AdamC19/RMC-Computer-2021/README.md

# Computer Board for NASA RMC 2021
These are the hardware files for our main computer board for our 2021 entry for NASA RMC: Lunabotics.
