AdamC19/RMC-Computer-2021/Project Outputs for Computer_Board/Computer_Board_BoM.xlsx

Manufacturer PN | Description | Designator | Quantity | Cost
BU2032SM-JJ-GTR | Battery Holder, Coin Cell CR2032, SMD | BT1 | 1 | 1
 | CAP, 0.1uF, ±10%, 16V, X7R, 0603 | C1, C12, C16, C19, C30, C31, C32, C35, C36, C38, C39, C44, C45, C46, C47, C48, C49, C50, C51, C52, C53, C56, C57, C58, C59, C60, C61, C62, C63, C64, C65, C66, C67, C68, C69, C70, C71, C72, C73, C74, C75, C76, C78, C83, C85, C86, C87, C88, C90, C91, C92, C93, C94, C95, C96, C97, C98, C102, C103, C104, C105, C109, C110, C112, C113, C122, C123, C124, C125, C130 | 70
CL31B106KAHNNNE | CAP, 10uF, ±10%, 25V, X7R, 1206 | C2, C3, C5, C7, C8, C13, C14, C15, C20, C21, C22, C25, C26, C33, C34, C40, C41, C42, C43, C77, C84 | 21
GRM21BR71C105KA01K | CAP, 1uF, 10%, 16V, X7R, 0805 | C4, C18, C23, C37, C80, C117, C118, C119, C120, C121 | 10
C1210C476M9RACTU | CAP, 47uF, ±20%, 6.3V, X7R, 1210 | C6, C17, C24 | 3 | $1.08
 | CAP, 10000pF, ±10%, 16V, X7R, 0603 | C9, C27, C89 | 3
GRM1885C1H390FA01D | CAP, 39pF, ±1%, 50V, C0G, 0603 | C10, C28 | 2
GRM1885C1H102FA01D | CAP, 1000pF, ±1%, 50V, C0G, 0603 | C11, C29, C99, C100, C101, C106, C107, C108, C111, C114, C115, C116 | 12
GRM1885C1H470GA01J | CAP, 47pF, ±2%, 50V, C0G, 0603 | C54, C55 | 2
GRM1885C1H471GA01D | CAP, 470pF, ±2%, 50V, C0G, 0603 | C79 | 1
GRM1885C1H180GA01D | CAP, 18pF, ±2%, 50V, C0G, 0603 | C81, C82 | 2
T495X227K016ATE100 | CAP, 220uF, ±10%, 16V, Tantalum, 100mOhm, 2917 | C126, C127, C128 | 3 | $2.57
UCW1E471MNL1GS | CAP, 470uF, ±20%, 25V, Al, SMD, 7000hrs at 105°C | C129 | 1 | $0.70
SS5P6-M3/86A | Dio, Schottky, 5A, 0.63V, 60V, TO-227 | D1, D2, D3, D4 | 4 | 0.6
DLPT05-7-F | TVS, Steering (Rail-Rail), 9.8V Clamping, 17A Peak Pulse, SOT-23 | D5, D6, D9, D10, D11, D12, D13, D14, D21, D22, D23, D24, D25, D26, D27, D28, D29, D30, D31, D32, D33, D34, D35, D36, D37, D38 | 26 | 0.38
MBR140SFT1G | Dio Shtky, 1A, 0.55V, 40V, SOD-123 | D7, D15, D16, D17, D20, D39 | 6
APT1608LVBC/D | LED, Blue, 0603, Low current, HELI2 Series | D8, D18, D19 | 3 | 0.58
PTS12066V050 | PTC Resettable fuse, 6V, 500mA, 1206 | F1, F3, F4, F5, F6, F8, F9, F10, F11 | 9 | 0.3
1210L150/16WR | PTC Fuse (Polyfuse), 16V 1.5A Hold, 3A Trip, 300ms | F2, F7 | 2 | 1
TSW-102-07-F-S | Header, 2x1, 0.1" | J1, J18, J20, P2 | 4 | 0.2
1-1393644-6 | DIN 41612 Plug, 96-Pos, Male Pins, Right-Angle | J2 | 1 | 7.49
3-1827253-6 | Plug, 220 pos, COM Express Board-Board connector | J3 | 1 | 18.99
0470531000 | Header, 4-Pos, Molex-47053, (CPU Fan Header) | J4 | 1 | 0.46
J0G-0003NL | RJ45 Modular Mag-jack, 8P8C, 1000 Base-T, Horizontal | J5 | 1 | 10.26
1003-004-01010 | USB-A Jack x2, USB 3.0, Right-Angle, Thru-Hole | J6 | 1 | 3.55
UJ2-ADH-1-TH | USB-A Jack x2, USB 2.0, Right-Angle, Thru-Hole | J7, J8 | 2 | 0.95
10029449-111RLF | HDMI Type A Jack, Right-Angle, SMD+Thru-Hole | J9 | 1 | 0.8
2199230-4 | Card-Edge Socket, NGFF (M.2) E-Keyed, PCIe Card Socket | J10 | 1 | 1.33
1040310811 | Micro SD Card Slot, Push-Pull w/ Card-Detect Switch, SMD, Molex | J11 | 1 | 2.02
RJMG1BD3B8K1ANR | RJ45 Modular Mag-Jack, 8P8C, 10/100 Base-T | J12 | 1 | 3.92
1932638-3 | USB-A Jack, USB 2.0, SMD Right-Angle | J13 | 1 | 1.52
 | Net Tie | J14, J15, J16, J17 | 4
 | Header 6x1, 0.1" | J19, P3, P4 | 3
DFE252012P-R47M=P2 | Ind, 470nH, 4A, 0.027 Ohm, 1008 | L1, L5 | 2 | 0.51
IHLP3232DZER100M01 | Ind, 10uH, 20%, 5.2A (9A sat.), 0.0599 Ohm | L2, L6 | 2 | 1.65
MLZ2012A1R0WTD25 | Ind, 1uH, 20%, 900mA, 0805 | L3 | 1
SRN5040-3R3M | Ind, 3.3uH, 3.3A (3.8A sat.), 0.027 Ohm | L4 | 1 | 0.46
PE-0805PFB600ST | Fe Bead, 60 @ 100MH, 3A, 0805 | L7, L8, L9, L10, L11, L12, L13, L20, L21 | 9 | 0.1
BLM18AG121SN1D | Fe Bead, 120 @ 100MHz, 800mA, 0603 | L14, L15, L16, L17, L18, L19 | 6 | 0.1
BCM1.STR | BeagleCore BCM1, System-On-Module (SOM) | MOD1 | 1
RAPC722X | Barrel Jack, 2.0x5.5mm IDxOD, Right-Angle | P1 | 1 | 1.64
BSS138 | XSTR NMOS, 220mA, 50V, Vgs 1.3V, SOT-23-3 | Q1, Q2, Q3, Q4, Q5, Q6, Q7, Q8, Q9, Q10, Q11, Q12, Q13 | 13 | 0.31
ERJ-PA3F1002V | RES SMD 10K OHM 1% 1/4W 0603 | R1, R6, R8, R13, R14, R16, R18, R23, R24, R25, R26, R27, R28, R44, R45, R46, R53, R56, R57, R58, R59, R60, R61, R66, R67, R78, R79, R81, R82, R90, R91, R92, R93, R94, R95, R96, R101, R102, R103, R104, R106, R107, R114, R126, R127, R128, R133, R134 | 48 | 0.144
KTR10EZPF6042 | RES SMD 60.4K OHM 1% 1/8W 0805 | R2, R9 | 2
ERJ-PA3F2402V | RES SMD 24K OHM 1% 1/4W 0603 | R3, R10 | 2
ERJ-PA3F2703V | RES SMD 270K OHM 1% 1/4W 0603 | R4, R11 | 2
KTR10EZPF1152 | RES SMD 11.5K OHM 1% 1/8W 0805 | R5, R12 | 2
ERJ-PA3F3302V | RES SMD 33K OHM 1% 1/4W 0603 | R7 | 1
ERJ-PA3F1001V | RES SMD 1K OHM 1% 1/4W 0603 | R15, R129, R130 | 3
ERJ-PA3F2201V | RES SMD 2.2K OHM 1% 1/4W 0603 | R17, R38, R39, R41, R42, R108, R109, R131, R132 | 9
ERJ-PA3F3300V | RES SMD 330 OHM 1% 1/4W 0603 | R19, R20, R54, R62, R63, R68, R77 | 7
ERJ-PA3F1000V | RES SMD 100 OHM 1% 1/4W 0603 | R21, R22, R51, R52, R65, R74, R75, R76, R123, R124 | 10
ERJ-PA3F4703V | RES SMD 470K OHM 1% 1/4W 0603 | R29 | 1
RMCF0805ZT0R00 | RES SMD 0 OHM 1/8W 0805 Thick Film | R30, R31, R32, R33, R34, R35, R37, R47, R48, R49, R50, R64, R83, R125 | 14 | 0.1
ERJ-PA3F1003V | RES SMD 100K OHM 1% 1/4W 0603 | R36, R43, R55, R105 | 4
RMCF0603FT12K4 | RES SMD 12.4K OHM 1% 1/10W 0603 | R40, R80 | 2 | 0.1
RC0603FR-0749R9L | RES SMD 49.9 OHM 1% 1/10W 0603 | R69, R70, R71, R72 | 4 | 0.1
ERJ-PA3F1501V | RES SMD 1.5K OHM 1% 1/4W 0603 | R73, R111, R112, R113, R116, R117, R118, R119, R120, R121, R122 | 11
KTR10EZPF60R4 | RES SMD 60.4 OHM 1% 1/8W 0805 | R84, R87 | 2
KTR10EZPF4700 | 20 | R85, R86, R88, R89, R97, R98, R99, R100, R110, R115 | 10
EXB-38V101JV | RES ARRAY 4 RES 100 OHM 5% 62.5mW 1206 | RN1, RN2 | 2 | 0.1
B3FS-1012P | Switch, SPST-NO, Tactile, 6.3x6.0mm, SMD, 50mA 24VDC | SW1, SW2, SW3 | 3 | 0.71
DLW21HN900SQ2L | CMC, 330mA 2-CH 90 OHM @ 100MHz SMD | T1, T2, T3, T4, T5, T6, T7, T8, T9, T10, T11 | 11 | 0.53
TPS54561DPRR | REG, SW Buck Adj, 5A, 4.5-60V, 2.5MHz, TPS54561 | U1, U4 | 2 | 5.52
UWS-12/4.5-Q48N-C | Module, Isolated, 1/16 Brick, 12V 4.5A (54W) Negative Logic | U2 | 1 | 32
TPS562201DDCR | REG, Synchronous Buck, 2A, 4.5-17V Input, SOT-23-6, TPS562201 | U3 | 1 | 0.68
SN74LVC2G04 | Inverter, Dual, sot-23-6, SN74LVC2G04 | U5, U51, U52 | 3
TPD4E02B04DQAR | TVS, 4-Ch, ESD Protec, 3.6V 8.8V 10-USON | U6, U7, U15, U17, U24, U26, U27, U29, U30, U32 | 10 | 0.56
SN74LVC1G126DBVR | IC, Tri-State Buffer Non-Inverting, Single, 1.65-5.5V, SOT-23-5 | U8, U9, U12 | 3 | $0.32
SN74LVC1G11DBVR | IC, AND Gate, Single 3-Input, 1.65-5.5V, SOT-23-6 | U10, U11, U28 | 3 | $0.37
USBLC6-2SC6Y | ESD Protec, 2-Ch, 2.5pF, 17V clamping voltage, SOT23-6 | U13, U16, U20, U21, U22, U23, U34 | 7 | 0.73
TPS2066DGNR | IC, Power Switch 1:2, 8-MSOP | U14, U18, U19, U33 | 4 | 1.56
PTN3366BSMP | IC, Video Level Shifter, HDMI v1.4b, 32-HVQFN, PTN3366 | U25 | 1 | 0.94
LAN8710AI-EZK-TR | IC, 10/100 Ethernet Transceiver | U31 | 1 | 1.56
ADM3050EBRWZ | Isolated CANbus Transceiver, Single channel, ADM3050E | U35 | 1 | 9.62
TLP291-4 | Opto-Coupler Array, Photo-Transistor Output, TLP291-4 | U36, U39 | 2
SN74HC138DR | IC, 3:8 Decoder/Demux, SOIC-16, 2V-6V | U37 | 1 | $0.37
ADuM3211ARZ | Digital Isolator, Dual-Channel, ADuM3211 | U38, U49 | 2 | 2.87
ISO1541DR | IC, Bidirectional I2C Isolator, 2500 Vrms, Low Power, SOIC-8 | U40 | 1 | 4.05
ADT7310TRZ | IC, 0.5°C Accurate 16-bit Digital SPI Temperature Sensor, SOIC-8, ADT7310 | U41 | 1 | 3.93
LT1920CS8#PBF | IC, Instrumentation Amp, Single, 4.6 ~ 36V supply, SOIC-8 | U42, U45 | 2 | 7.61
SN74AHC1G125DBVR | Tri-State Buffer, Single, 2-5.5V, SOT-23-5, SN74AHC1G125 | U43 | 1 | $0.33
ADuM3153BRSZ | Digital Isolator, SPI-bus optomized, ADuM3151 | U44 | 1 | 6.69
DG408DY | Analog Mux, 8:1, 5 ~ 36V, SOIC-16 | U46, U48 | 2 | 1.77
ADS1220IPWR | IC, ADC 24-bit 4-Channel MUX-PGA, Sigma-Delta, 2k SPS, 16-TSSOP | U47 | 1 | 8.27
MAX232CSE+ | IC, RS-232 Transceiver, Dual Channel, SOIC-16 | U50 | 1 | 2.92
ECS-250-20-33-JTN-TR | XTAL, 25MHz, 20pF, 20ppm | Y1 | 1 | 0.56
