AdamC19/RMC-Computer-2021/Computer_Board.pdf

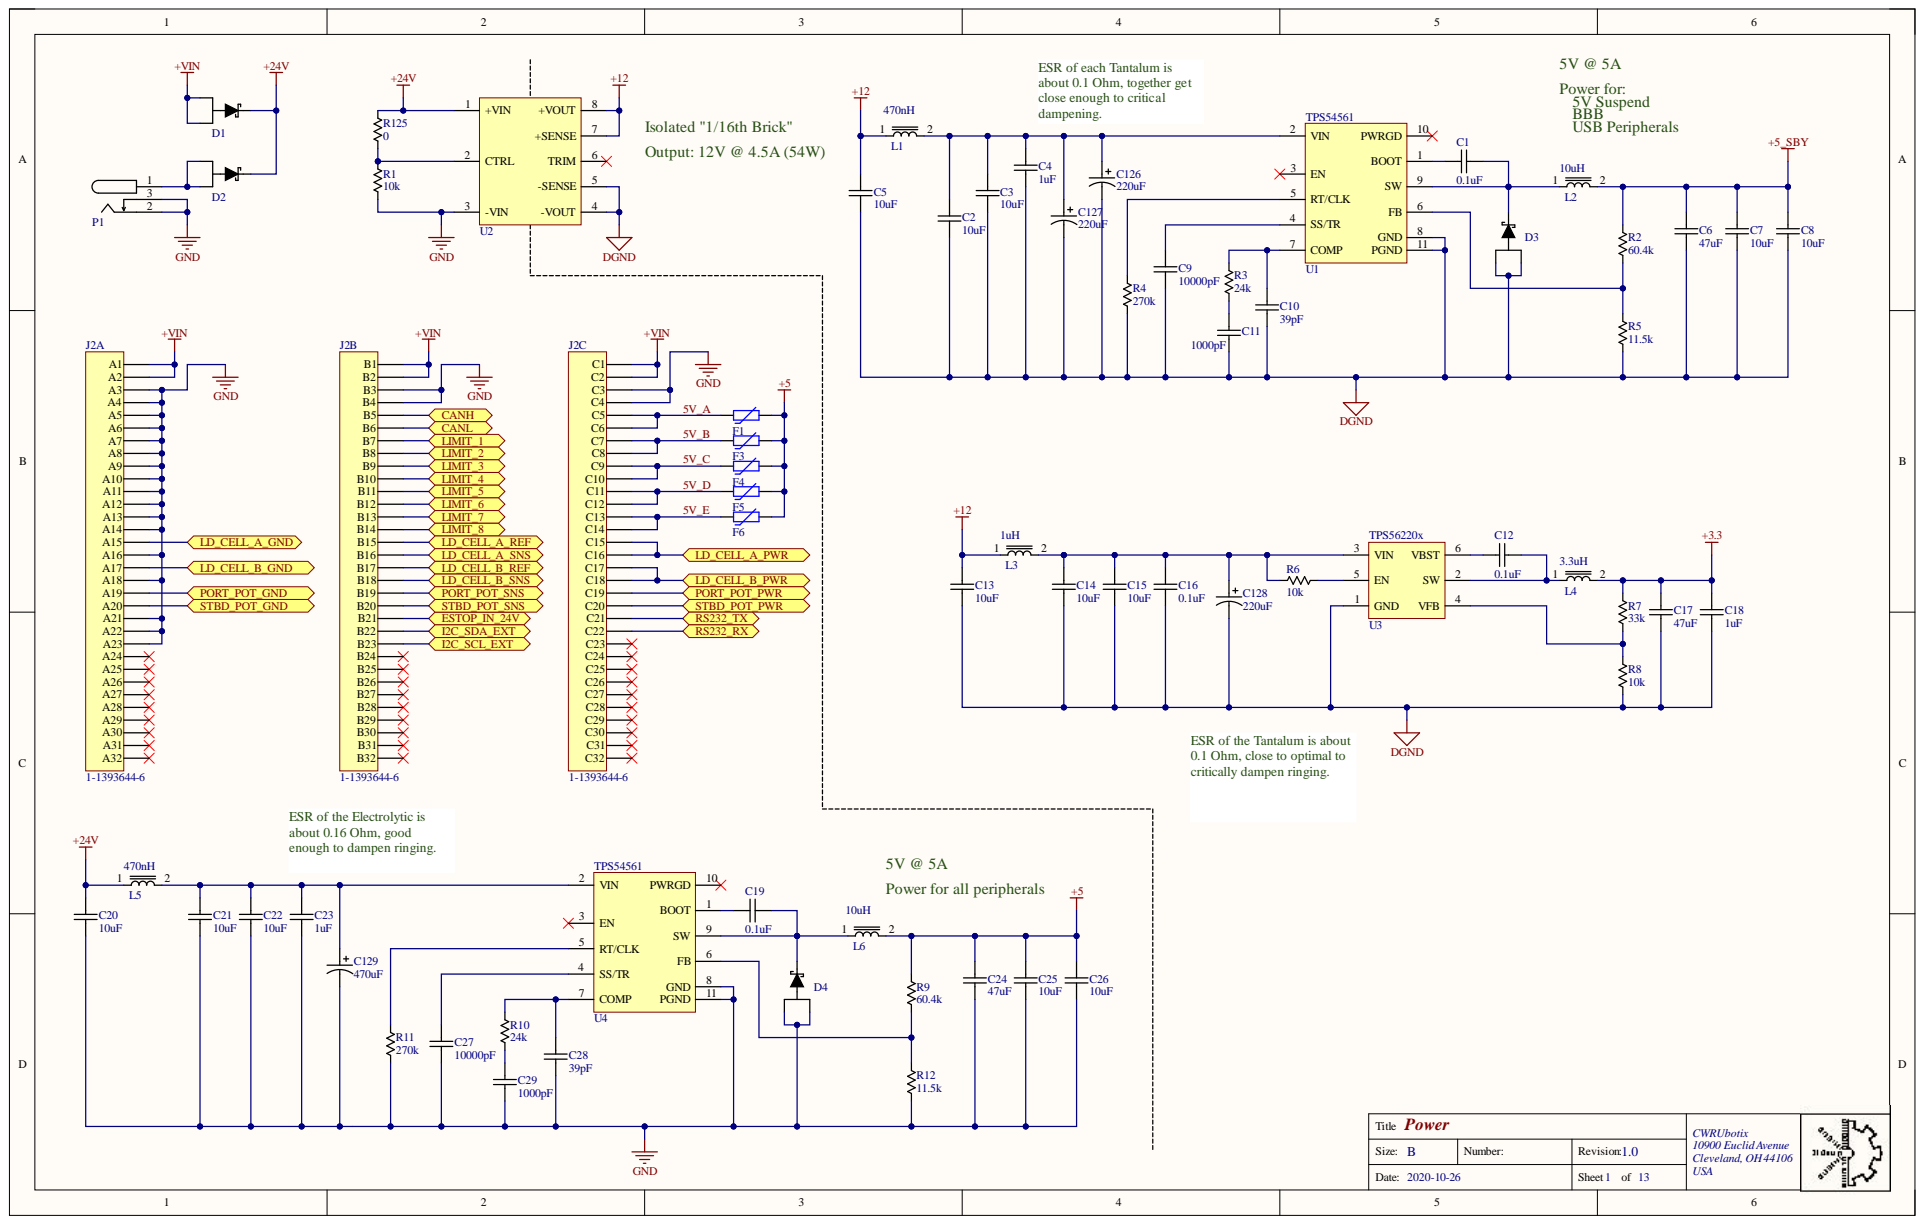
[picture p1: page 1]

ESR of each Tantalum is
about 0.1 Ohm, together get
close enough to critical
dampening.

Power for: 5V Suspend BBB

ESR of the Tantalum is about
0.1 Ohm, close to optimal to
critically dampen ringing.

ESR of the Electrolytic is
about 0.16 Ohm, good
enough to dampen ringing.

Power for all peripherals

Title Power | CWRUbotix 10900 Euclid Avenue Cleveland, OH44106

Size: B | Number: | Revision: 1.0

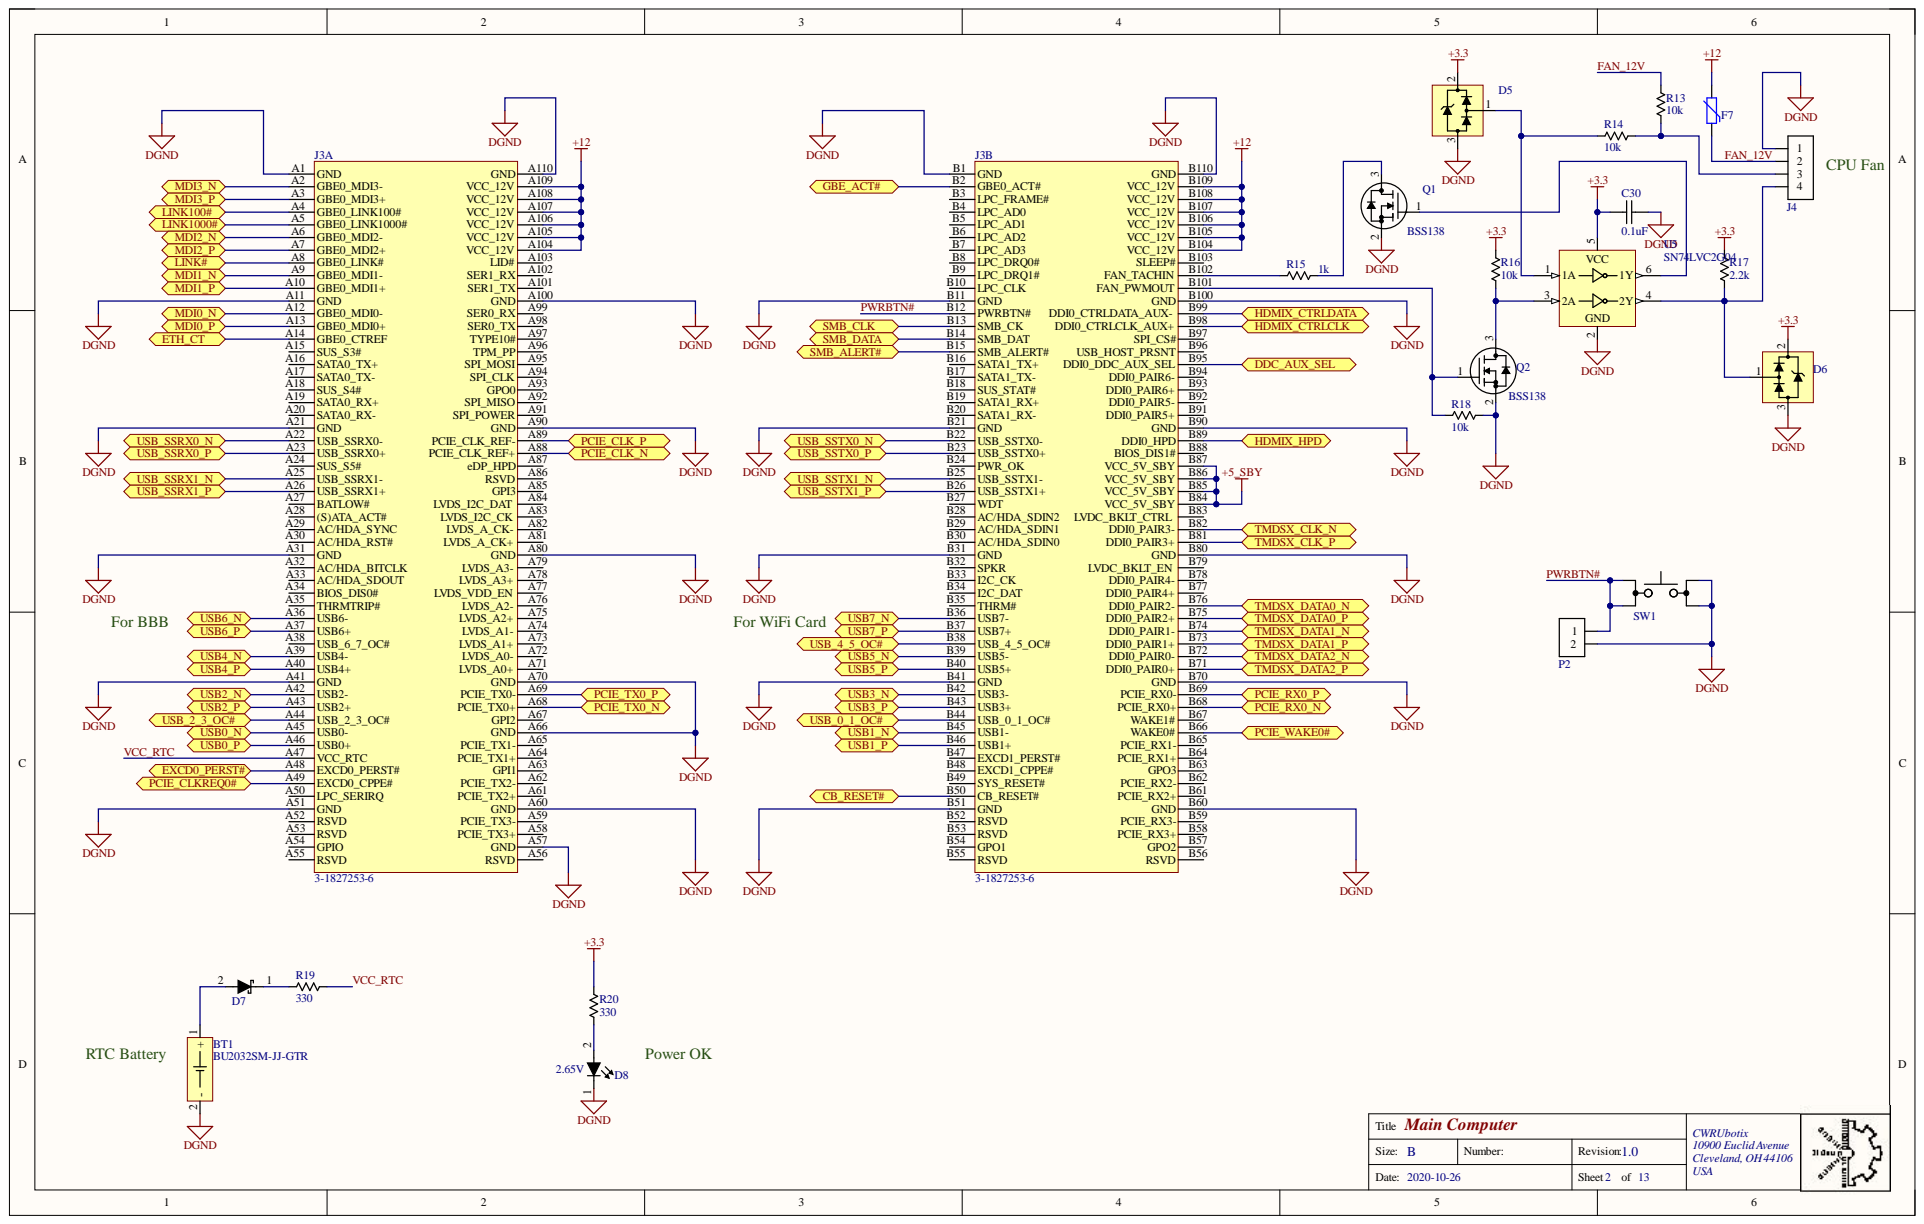
[picture p2: page 2]

Title Main Computer | CWRUbotix 10900 Euclid Avenue Cleveland, OH44106

Size: B | Number: | Revision: 1.0
Date: 2020-10-26 | | Sheet 2 of | USA 13

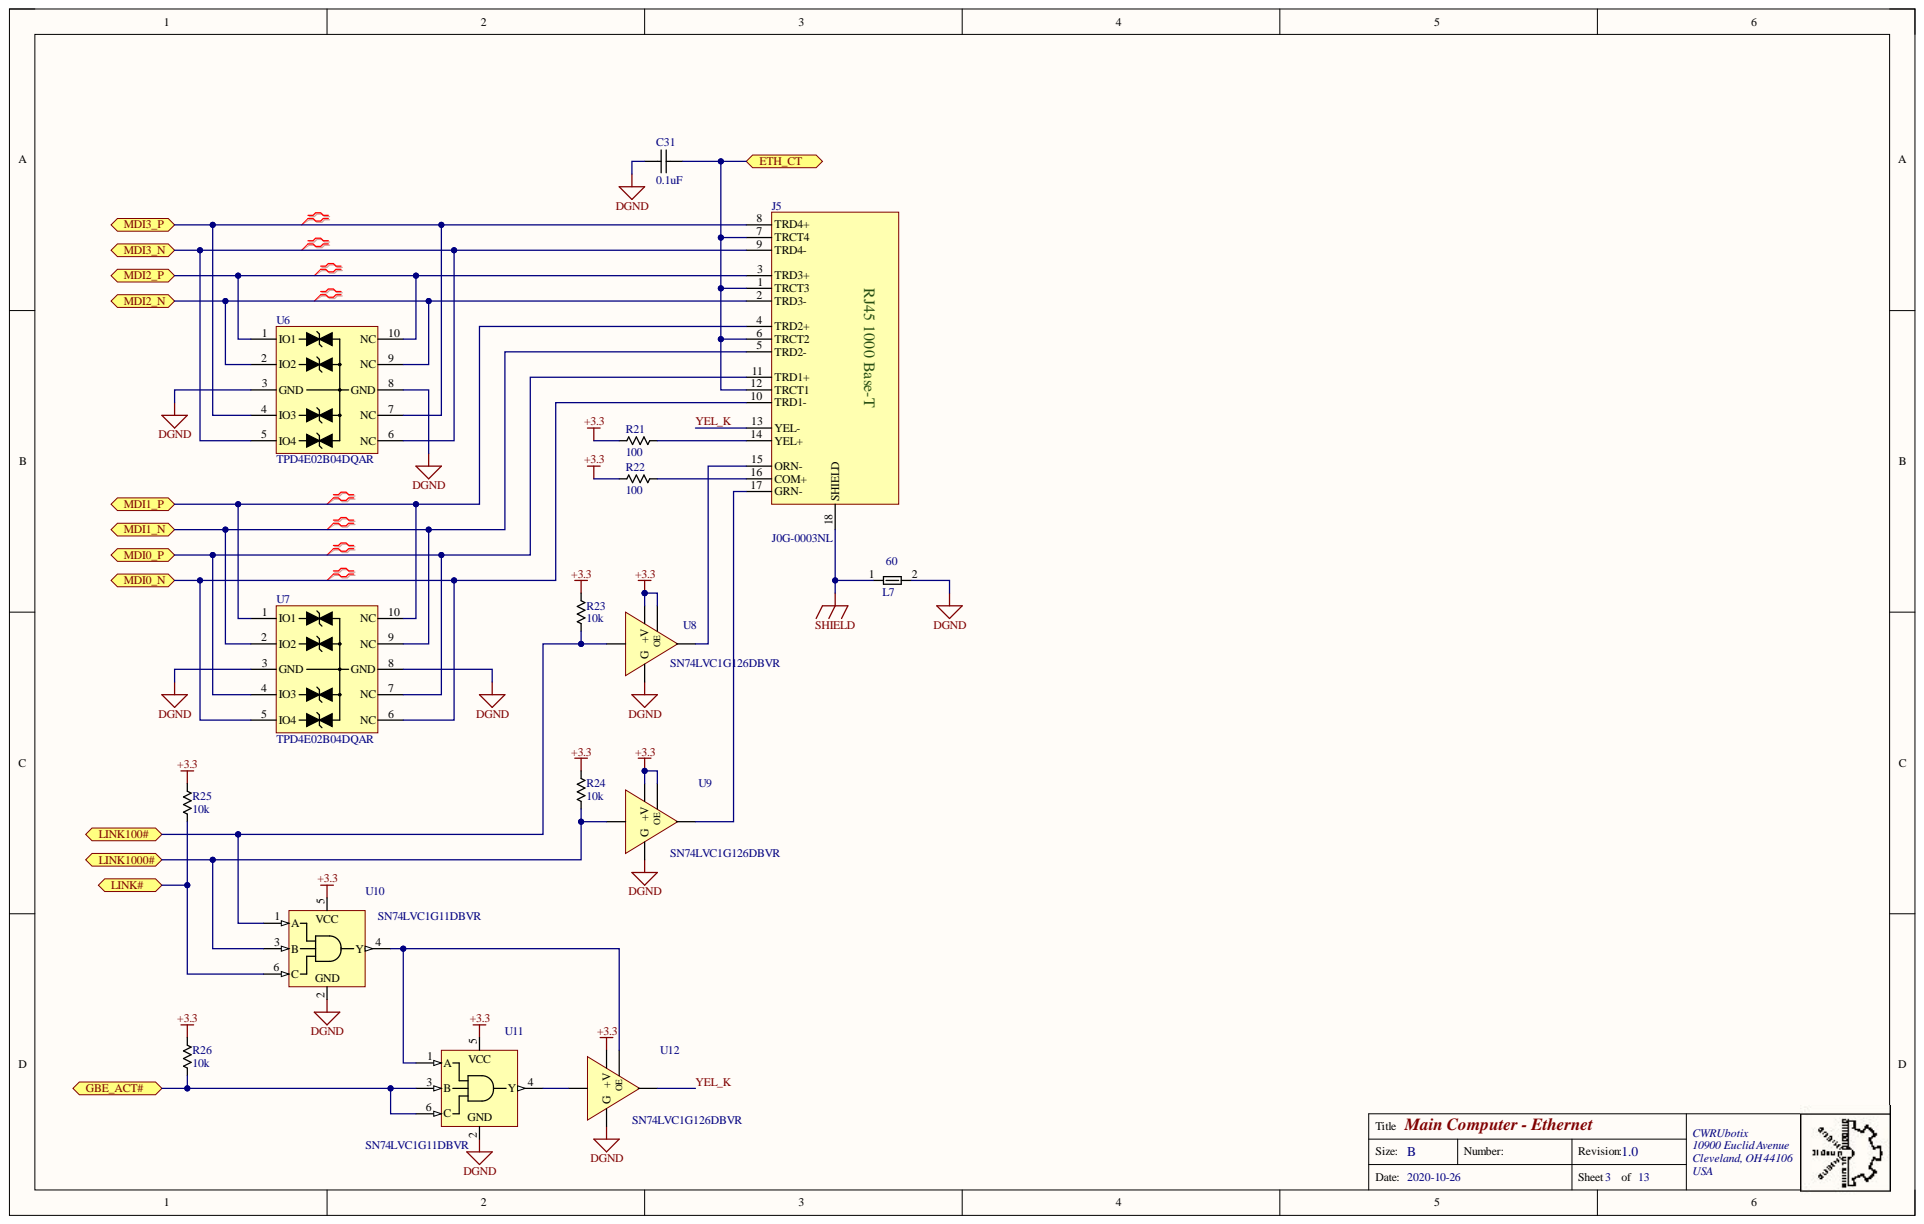
[picture p3: page 3]

TRD4- 9

TRD3+ 3
TRCT3 1
TRD3- 2

U6 | | TRD2+ 4

TRD2- 5 TRCT2 6

TRD1+ 11
TRCT1 12

Title Main Computer - Ethernet | CWRUbotix 10900 Euclid Avenue Cleveland, OH44106

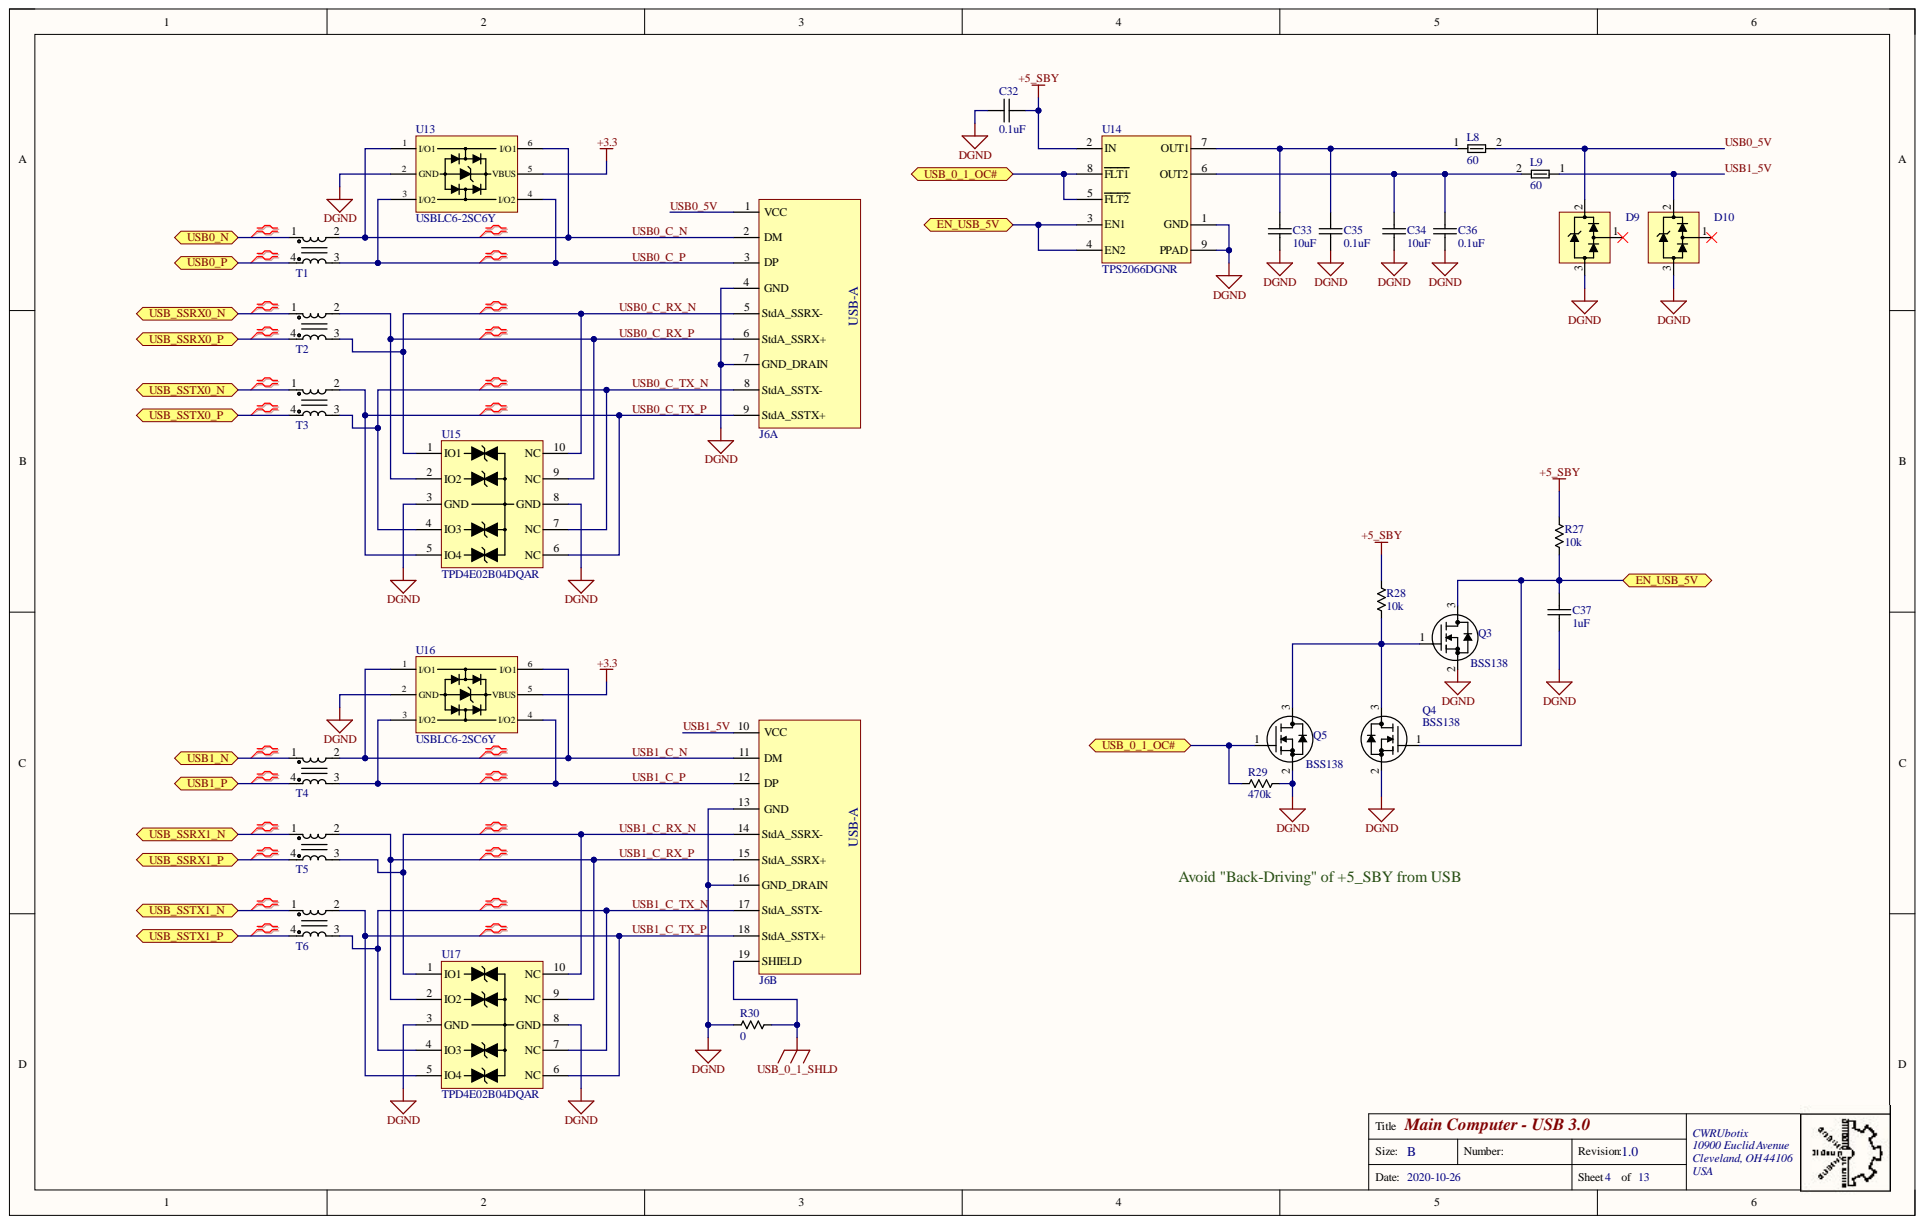
[picture p4: page 4]

StdA_SSRX- 5

USB0_C_TX_N | GND_DRAIN 7

StdA_SSTX- 8

USB0_C_TX_P

USB1_C_P | DP 12

GND 13

StdA_SSRX- 14

USB1_C_RX_P | | | StdA_SSRX+ 15

Avoid "Back-Driving" of +5_SBY from USB

USB1_C_TX_N | | | GND_DRAIN 16

StdA_SSTX- 17

USB1_C_TX_P | | StdA_SSTX+ 18

Title Main Computer - USB 3.0 | CWRUbotix 10900 Euclid Avenue Cleveland, OH44106

Size: B | Number: | Revision: 1.0
Date: 2020-10-26 | | Sheet 4 of | USA 13

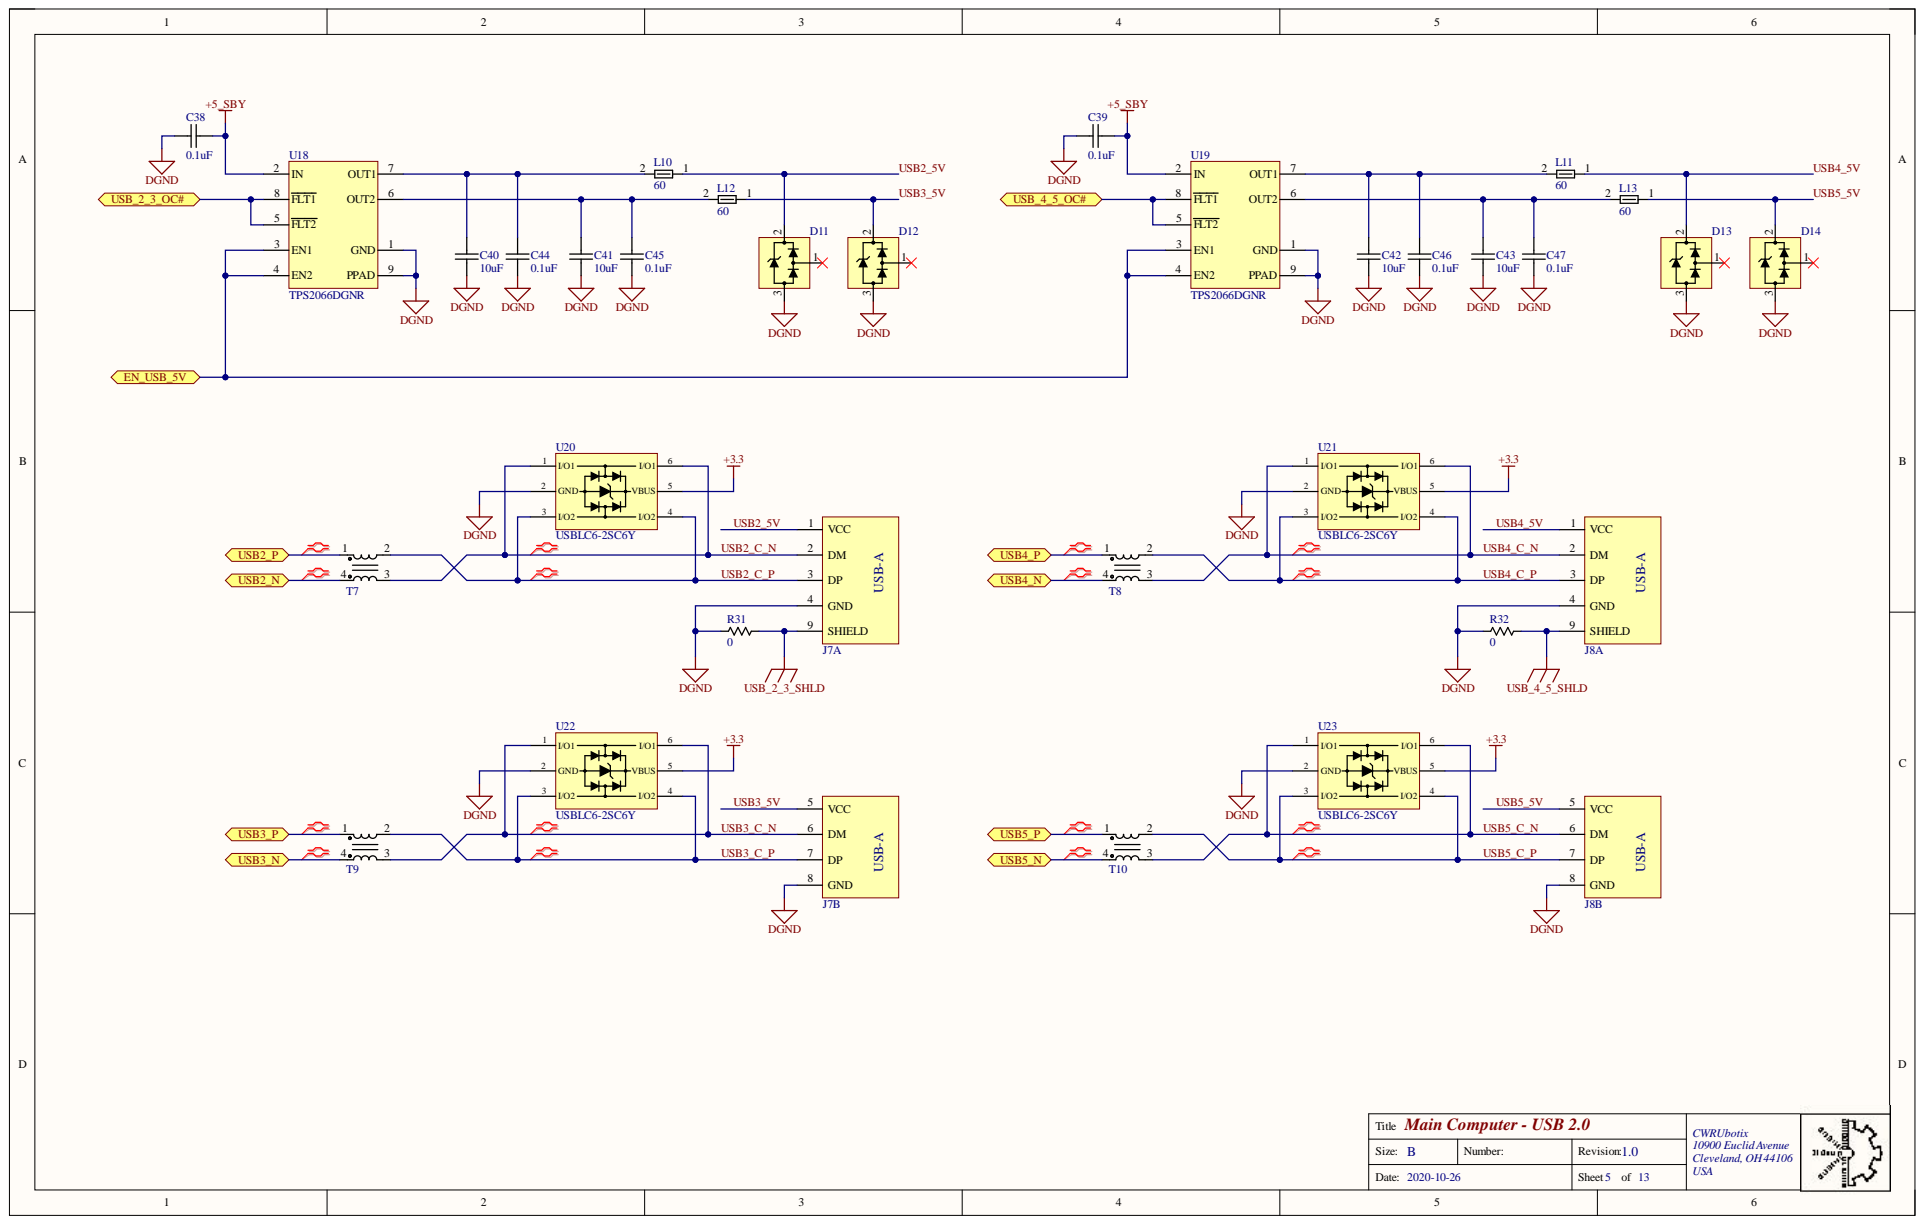
[picture p5: page 5]

Title Main Computer - USB 2.0 | CWRUbotix 10900 Euclid Avenue Cleveland, OH44106

Size: B | Number: | Revision: 1.0
Date: 2020-10-26 | | Sheet 5 of | USA 13

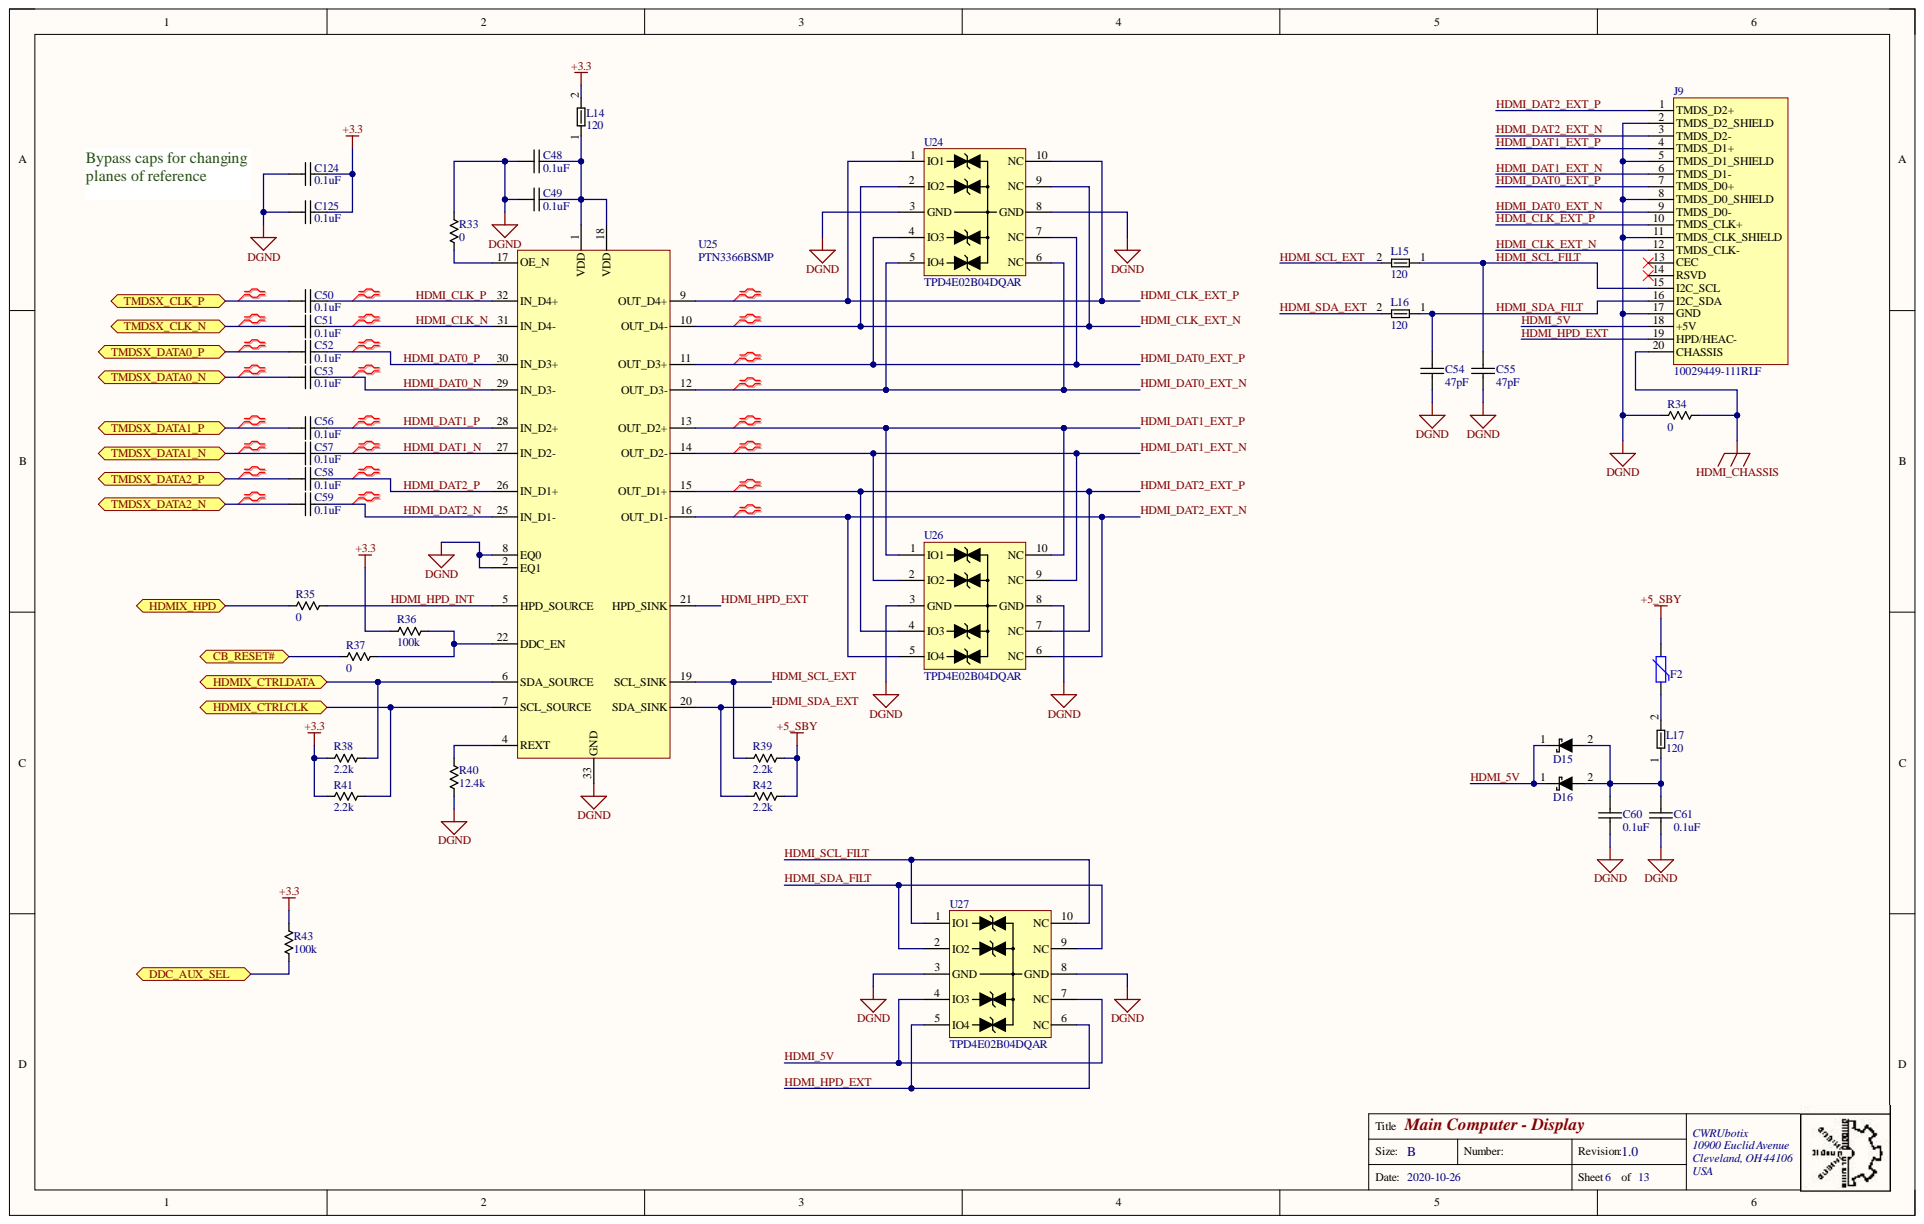
[picture p6: page 6]

Bypass caps for changing
planes of reference

0.1uF C59 | HDMI_DAT2_P

0.1uF | HDMI_DAT2_N

HDMI_SDA_FILT

HDMI_5V

HDMI_HPD_EXT

Title Main Computer - Display | CWRUbotix 10900 Euclid Avenue Cleveland, OH44106

Size: B | Number: | Revision: 1.0
Date: 2020-10-26 | | Sheet 6 of | USA 13

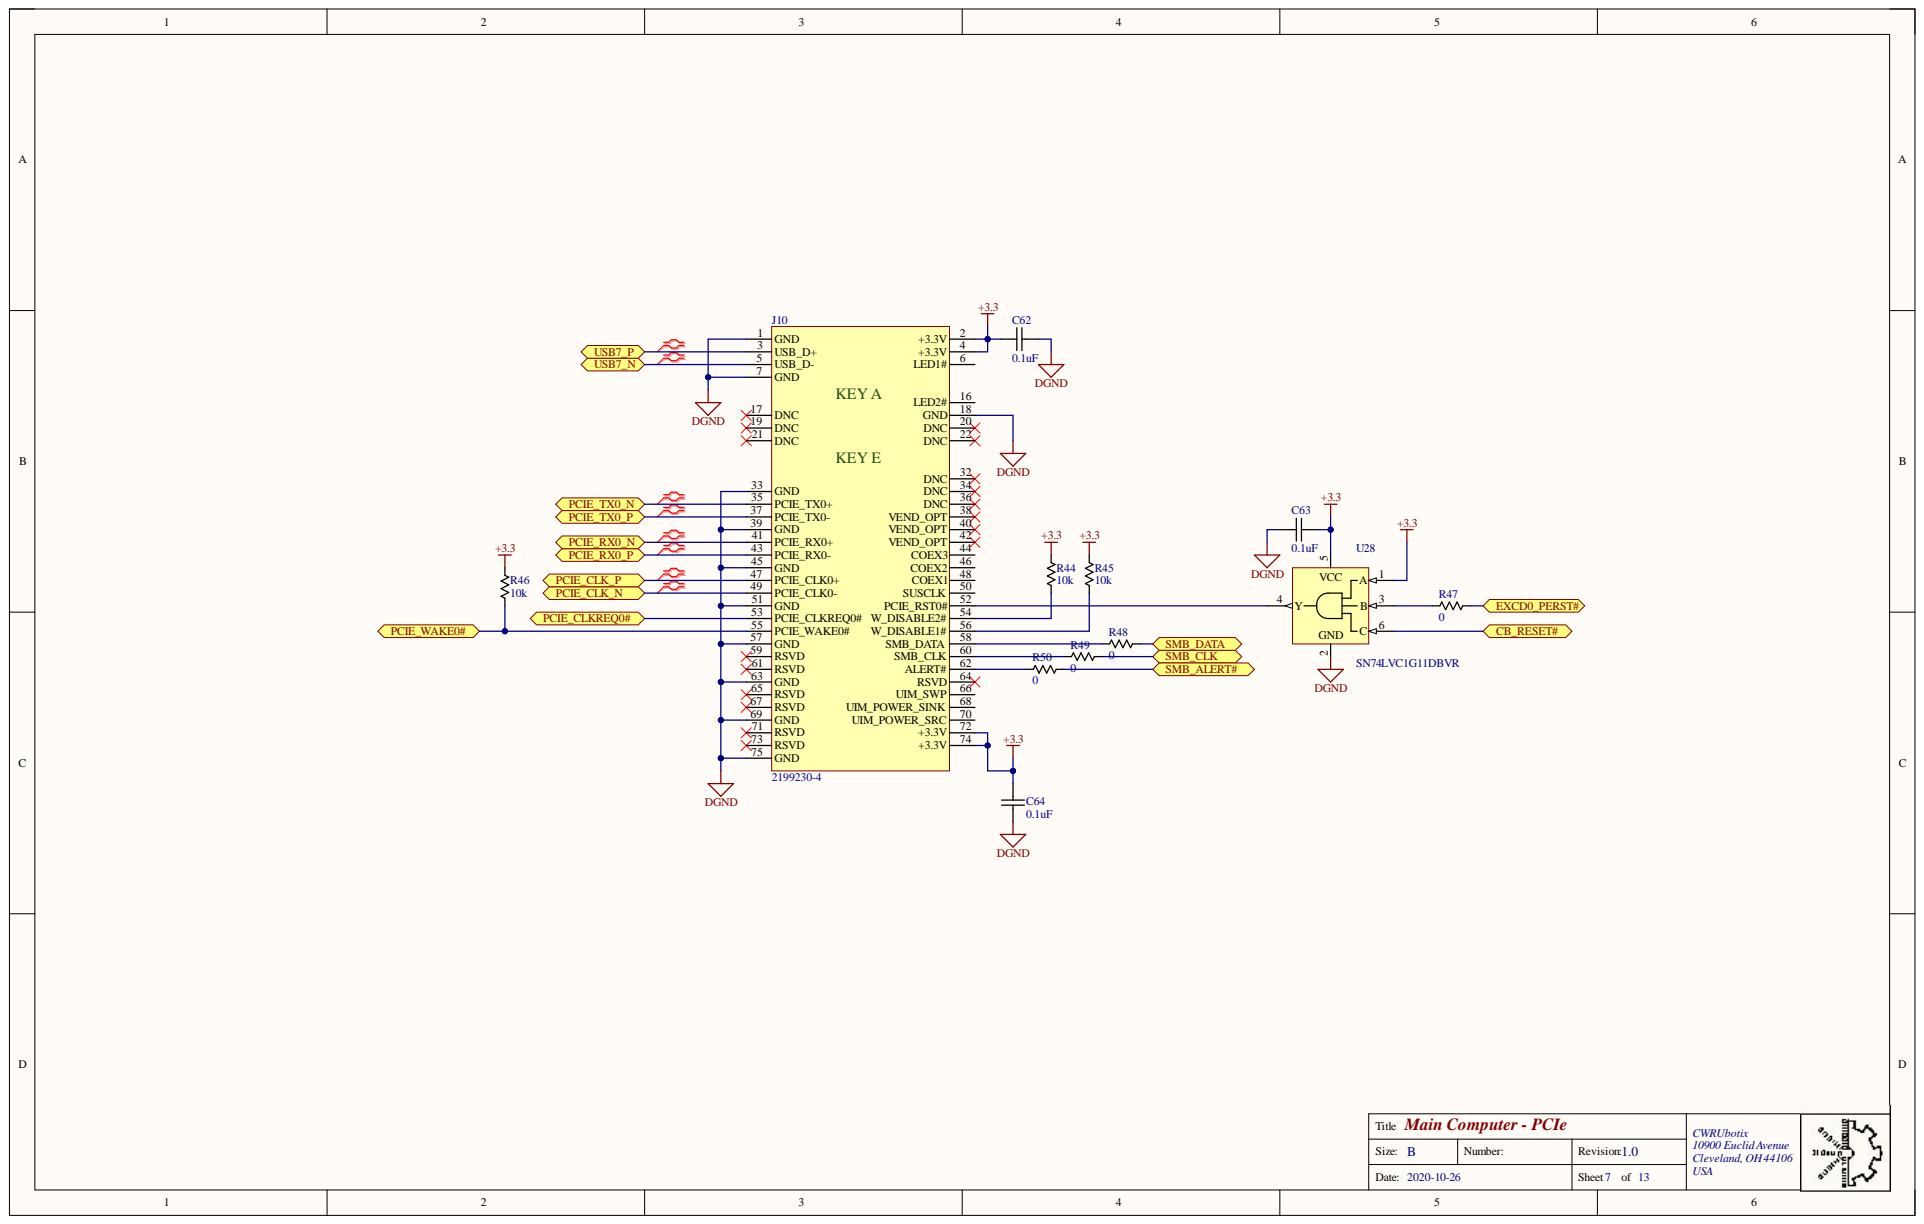
[picture p7: page 7]

Title Main Computer - PCIe | CWRUbotix 10900 Euclid Avenue Cleveland, OH44106

Size: B | Number: | Revision: 1.0
Date: 2020-10-26 | | Sheet 7 of | USA 13

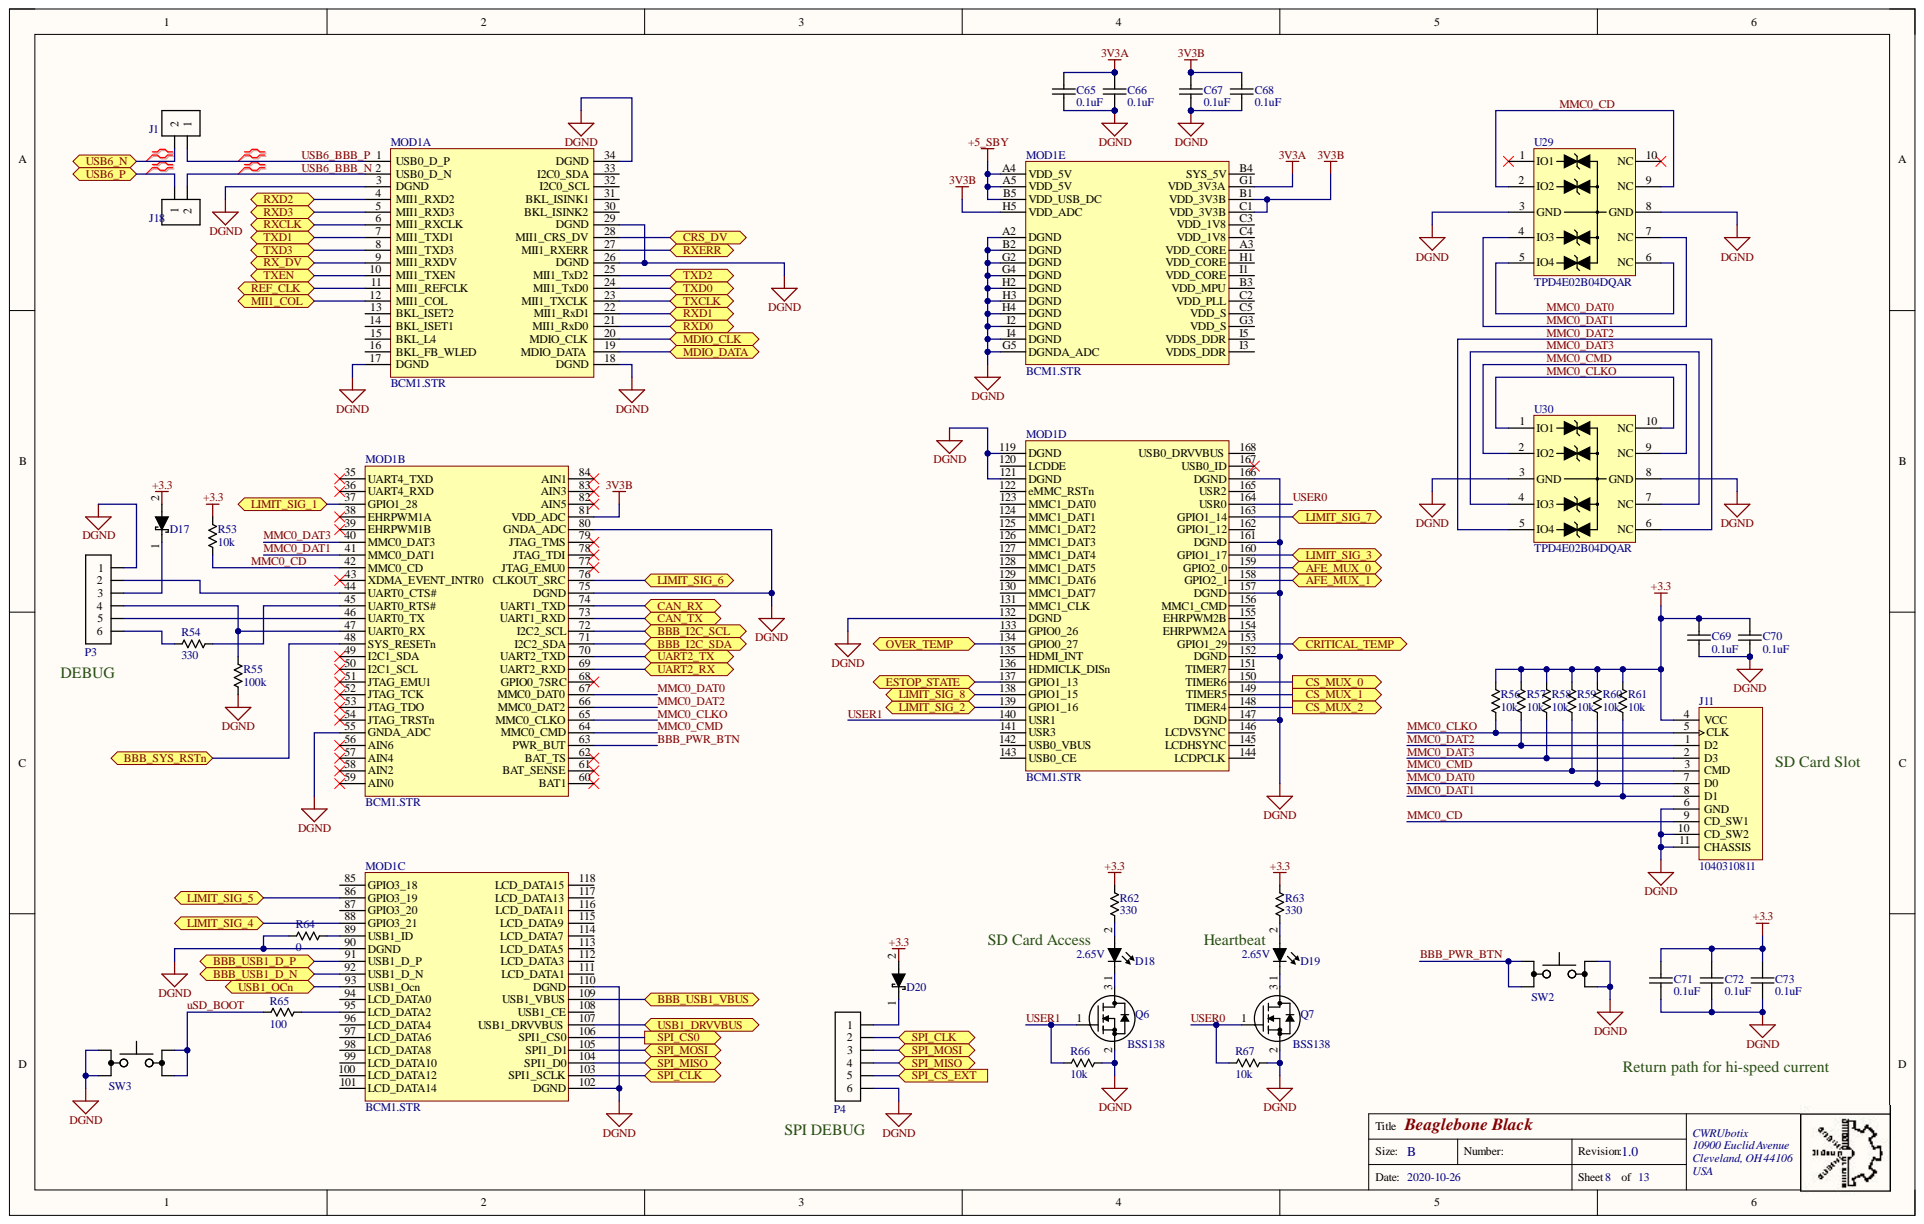
[picture p8: page 8]

CHASSIS 11

USB1_ID 89

USB1_D_P 91

Return path for hi-speed current

Title Beaglebone Black | CWRUbotix 10900 Euclid Avenue Cleveland, OH44106

Size: B | Number: | Revision: 1.0
Date: 2020-10-26 | | Sheet 8 of | USA 13

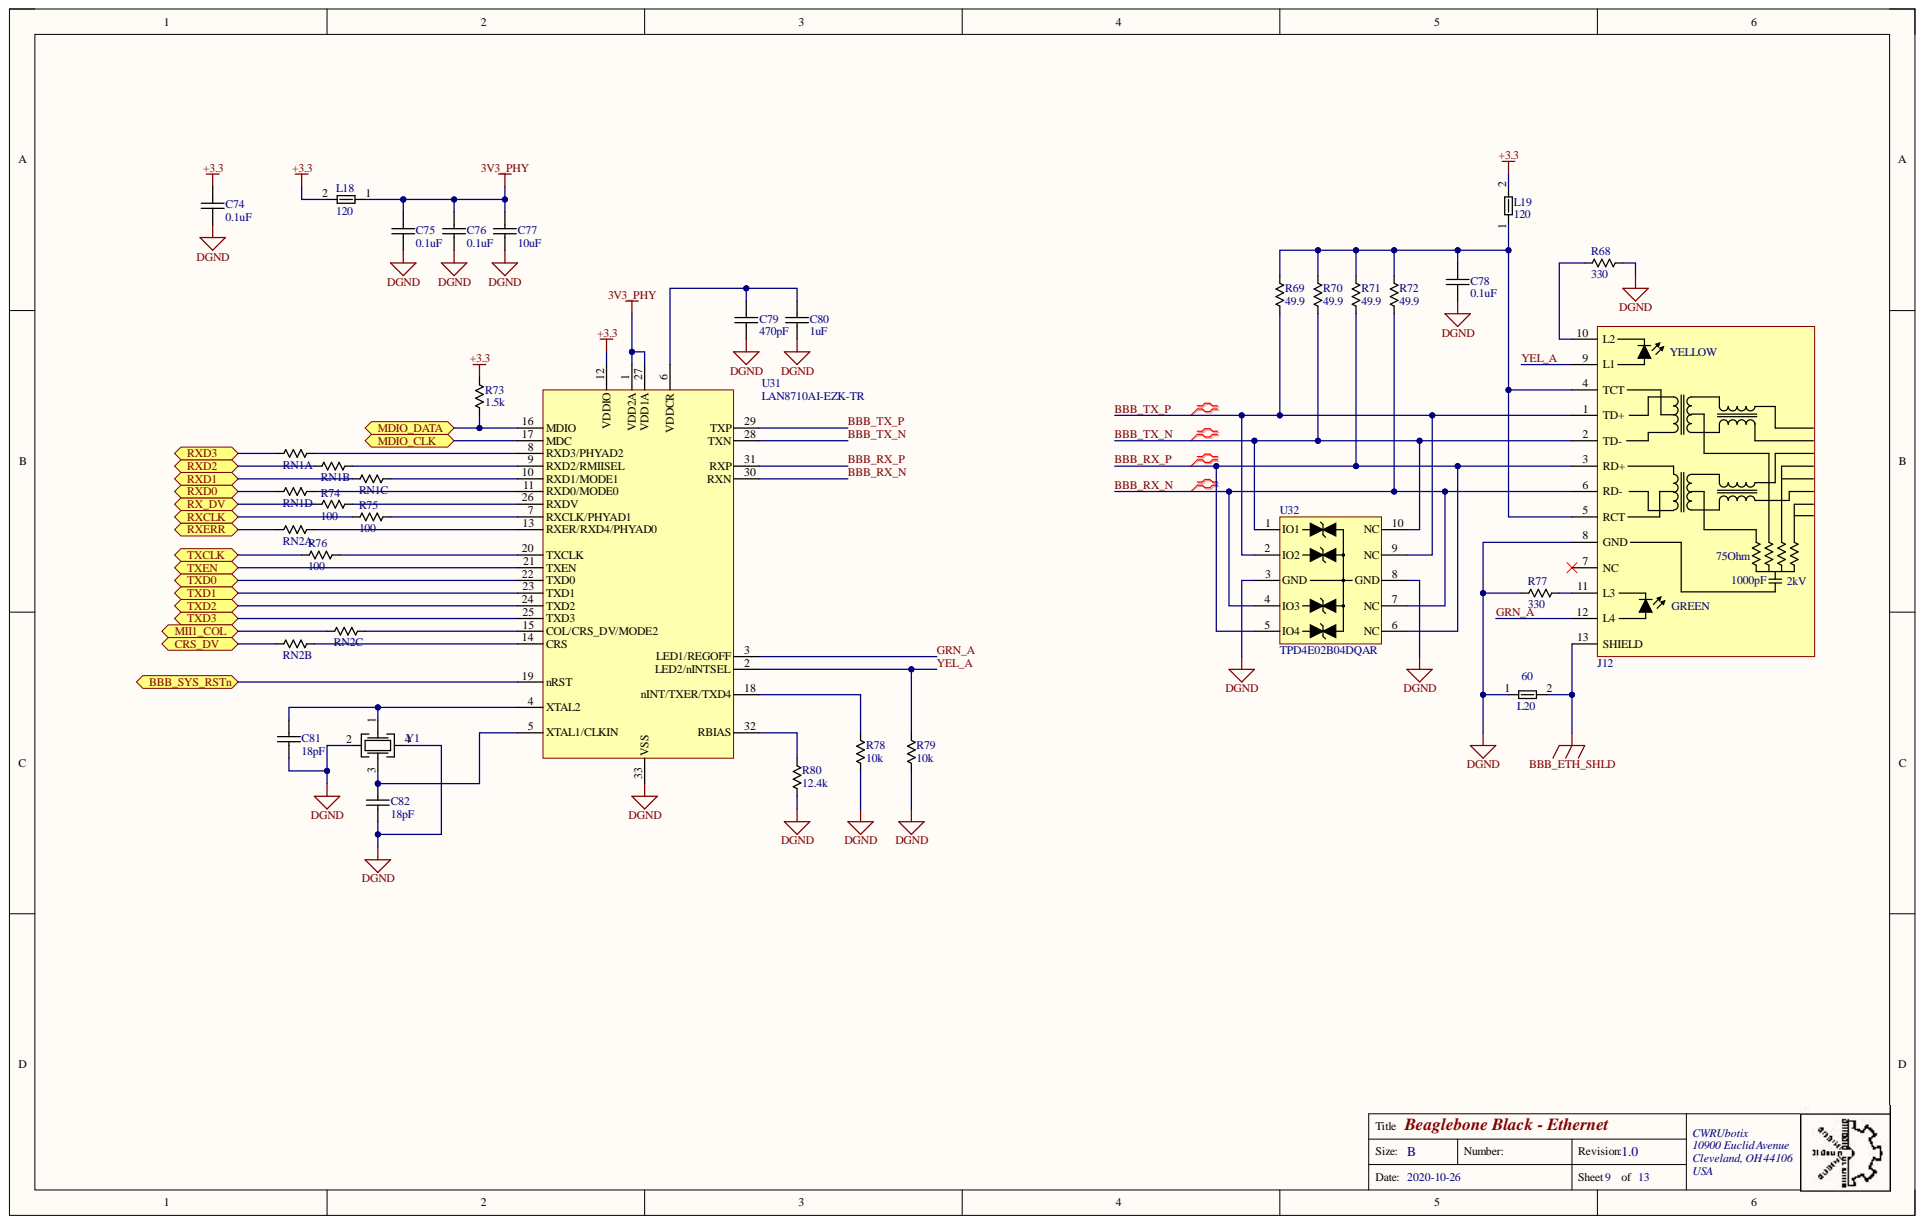
[picture p9: page 9]

Ti tl e Bea gleb one Black - Ethernet | C WR Ubot ix 10900 Eucl id Avenu e C leveland, OH44106

Si z e : B | N umber : | Revi s i on: 1 . 0
Dat e : 2020-10 -2 6 | | Sheet 9 of | USA 13

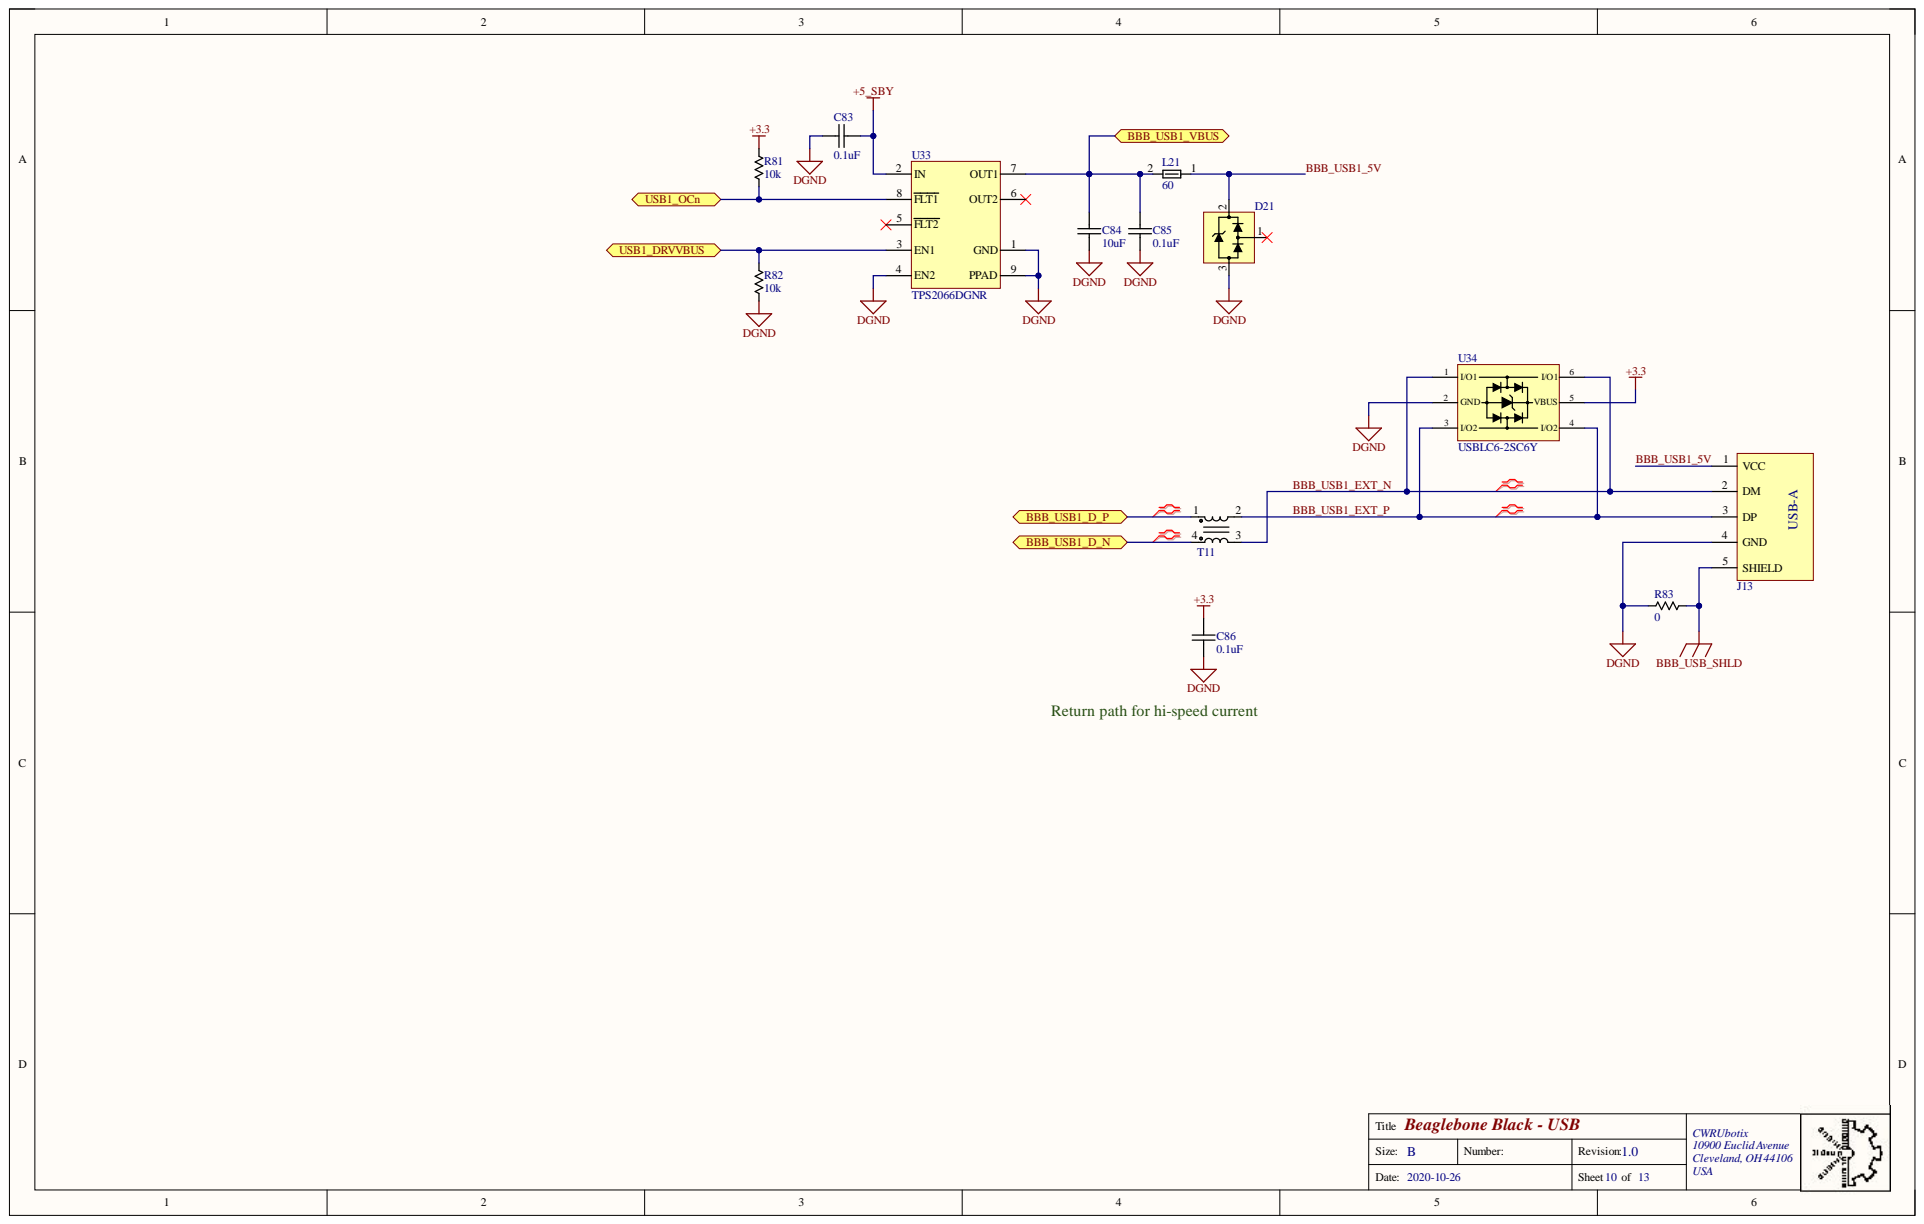
[picture p10: page 10]

BBB_USB1_EXT_P | | DP 3

GND 4

Return path for hi-speed current

Title Beaglebone Black - USB | CWRUbotix 10900 Euclid Avenue Cleveland, OH44106

Size: B | Number: | Revision: 1.0
Date: 2020-10-26 | | Sheet 10 of | USA 13

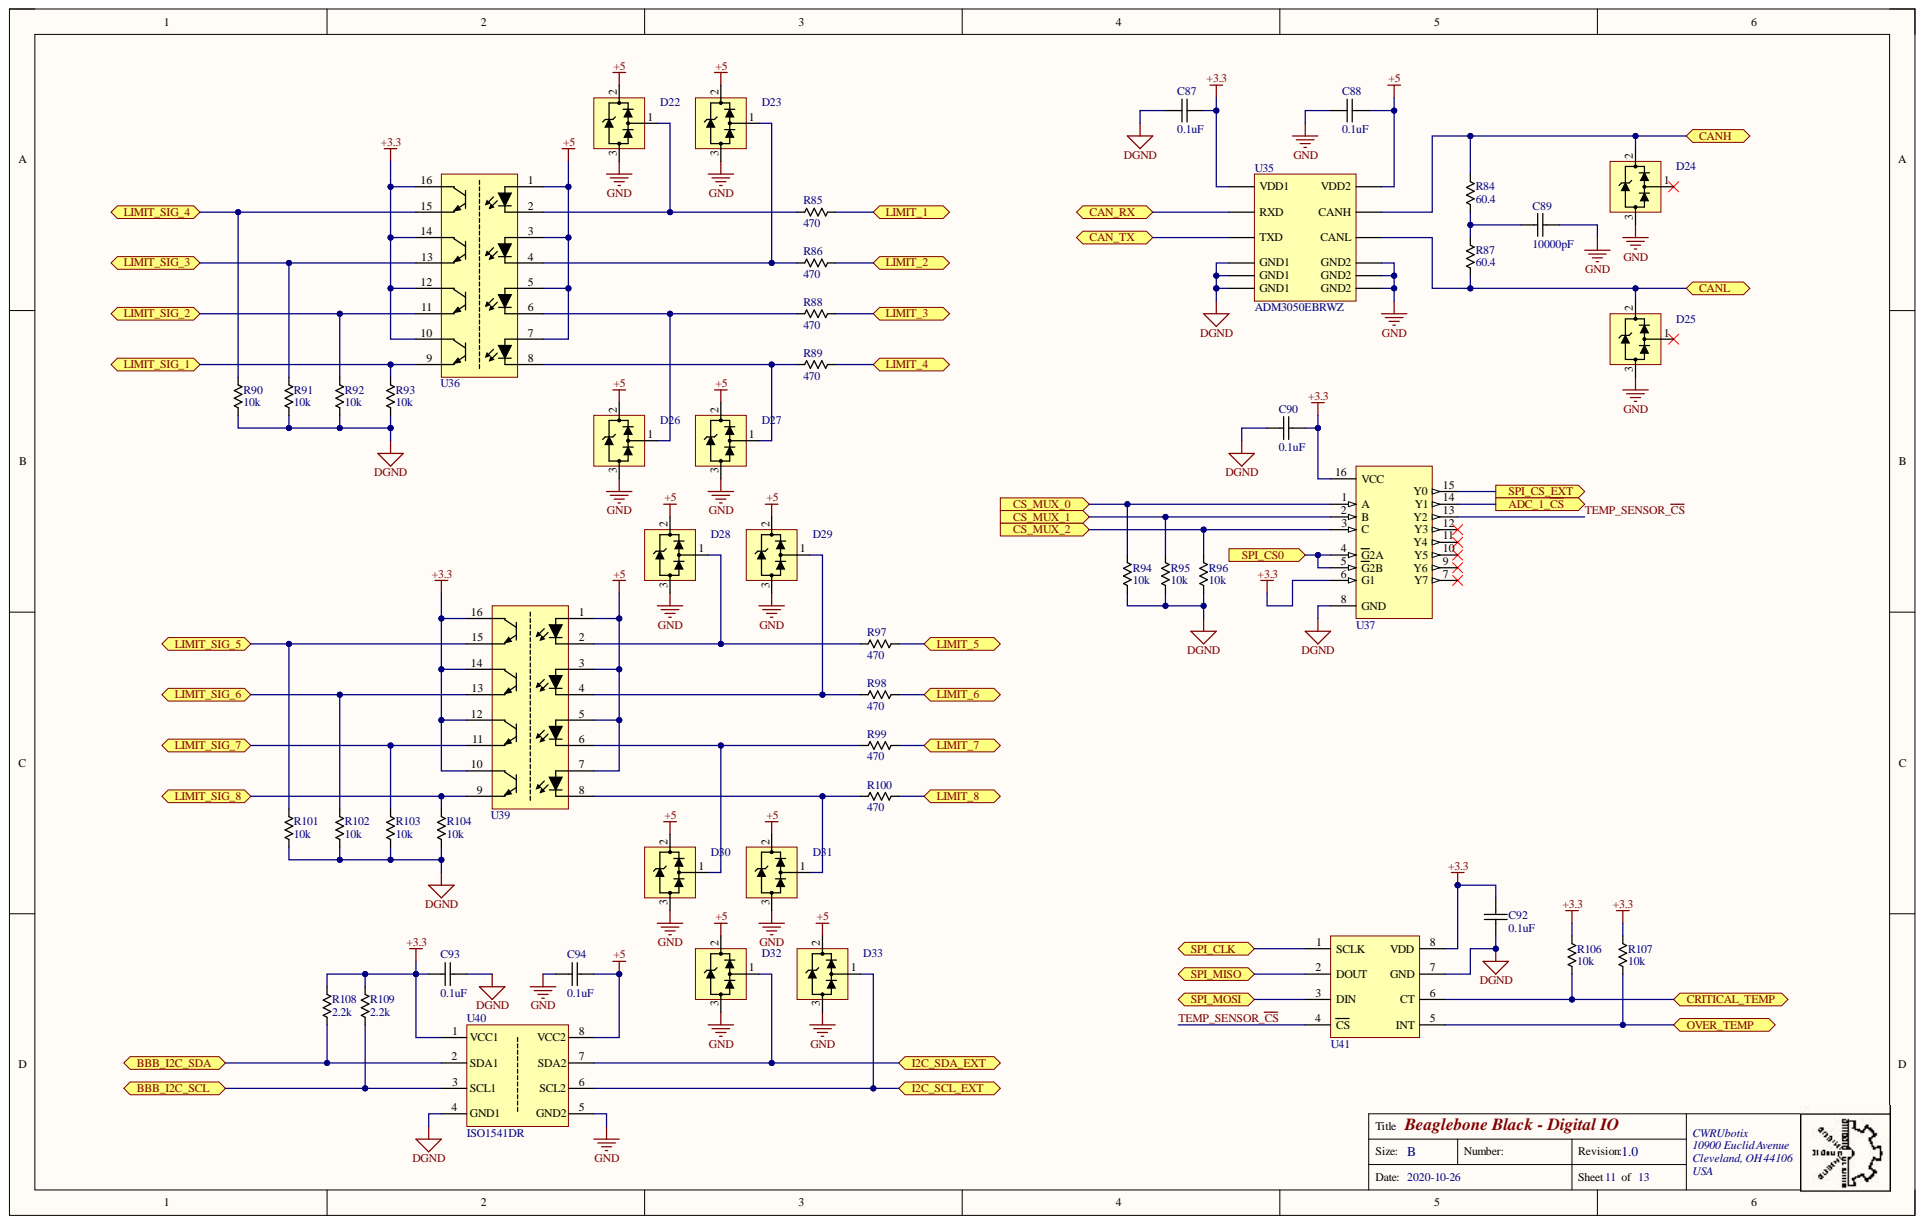
[picture p11: page 11]

GND 8

Beaglebone Black - Digital IO
Title

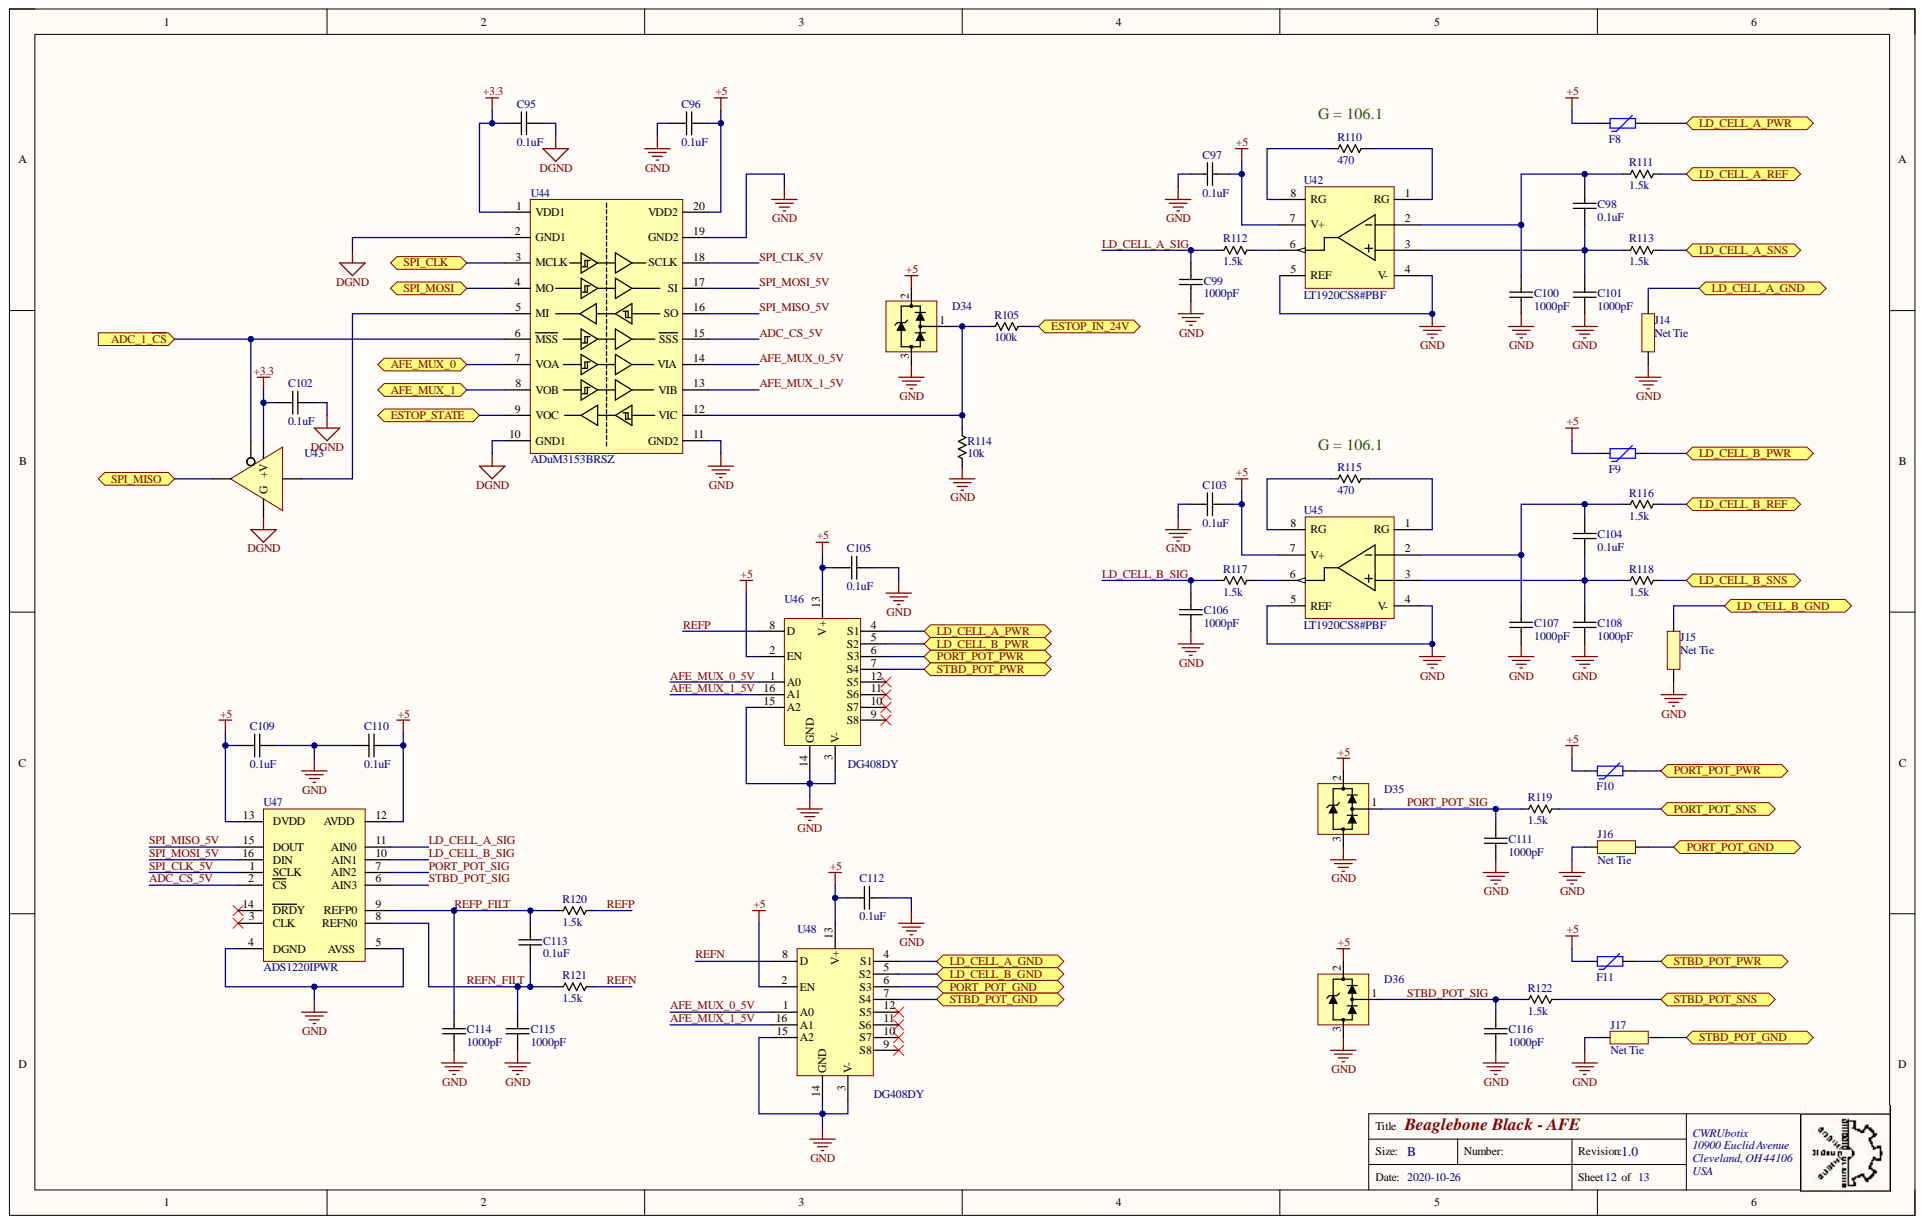
[picture p12: page 12]

Title Beaglebone Black - AFE | CWRUbotix 10900 Euclid Avenue Cleveland, OH44106

Size: B | Number: | Revision: 1.0
Date: 2020-10-26 | | Sheet 12 of | USA 13

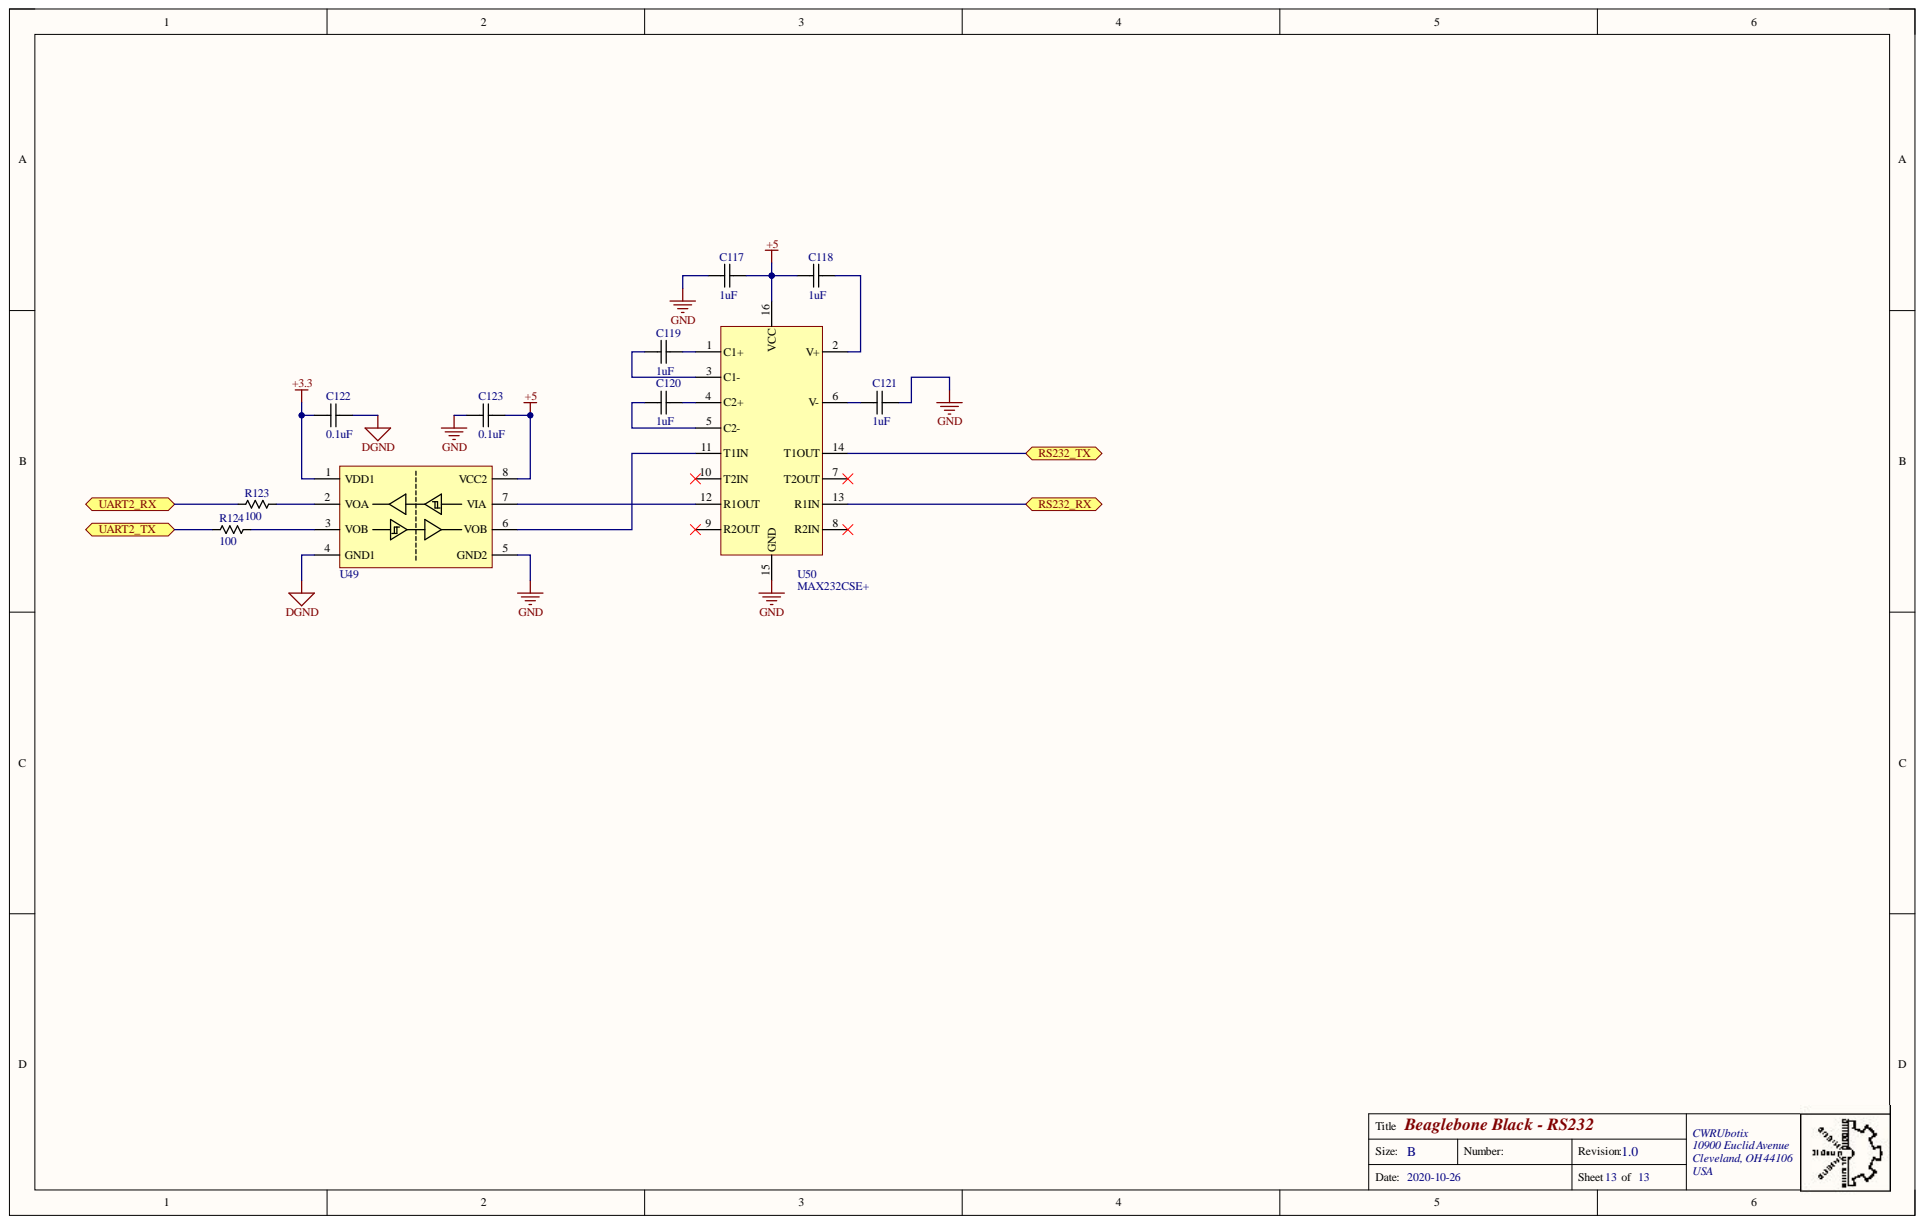
[picture p13: page 13]

Title Beaglebone Black - RS232 | CWRUbotix 10900 Euclid Avenue Cleveland, OH44106

Size: B | Number: | Revision: 1.0
Date: 2020-10-26 | | Sheet 13 of | USA 13
