AdamC19/RMC-Computer-2021/(list of files, drawings)

Other design files:
Computer_Board.PrjPcb
SCH1_Power.SchDoc
SCH2_Main_Computer.SchDoc
SCH3_Main_Computer_Eth.SchDoc
SCH4_Main_Computer_USB.SchDoc
SCH5_Main_computer_USB2-0.SchDoc
SCH6_Main_computer_Display.SchDoc
SCH7_Main_Computer_PCIe.SchDoc
SCH8_BBB.SchDoc
SCH9_BBB_Eth.SchDoc
SCH10_BBB_USB.SchDoc
SCH11_AFE.SchDoc
SCH11_Digital_IO.SchDoc
SCH12_AFE.SchDoc
SCH13_RS232.SchDoc
