AdamC19/RMC-Computer-2021/(commit log)

2020-10-19 Add PDF of schematics
2020-10-21 Power supply snubbers added, more layout work done, Sch PDF updated
    [Computer_Board.PrjPcb, SCH11_Digital_IO.SchDoc, SCH12_AFE.SchDoc, SCH1_Power.SchDoc, SCH8_BBB.SchDoc]
2020-10-23 done routing
    [SCH12_AFE.SchDoc]
2020-10-26 Give schematics titles and sheet numbers, clean up layout a little
    [Computer_Board.PrjPcb, SCH10_BBB_USB.SchDoc, SCH11_Digital_IO.SchDoc, SCH12_AFE.SchDoc, SCH13_RS232.SchDoc, SCH1_Power.SchDoc, SCH2_Main_Computer.SchDoc, SCH3_Main_Computer_Eth.SchDoc]
2021-09-05 Commit manufactured version to github
    [Computer_Board.GBL, Computer_Board.GBO, Computer_Board.GBS, Computer_Board.GM1, Computer_Board.GTL, Computer_Board.GTO, Computer_Board.GTP, Computer_Board.GTS]
